eSpark-Backup/saleemd-customproduct/Hardware-Development/Deliverables/Renderings/2D_Top.jpg

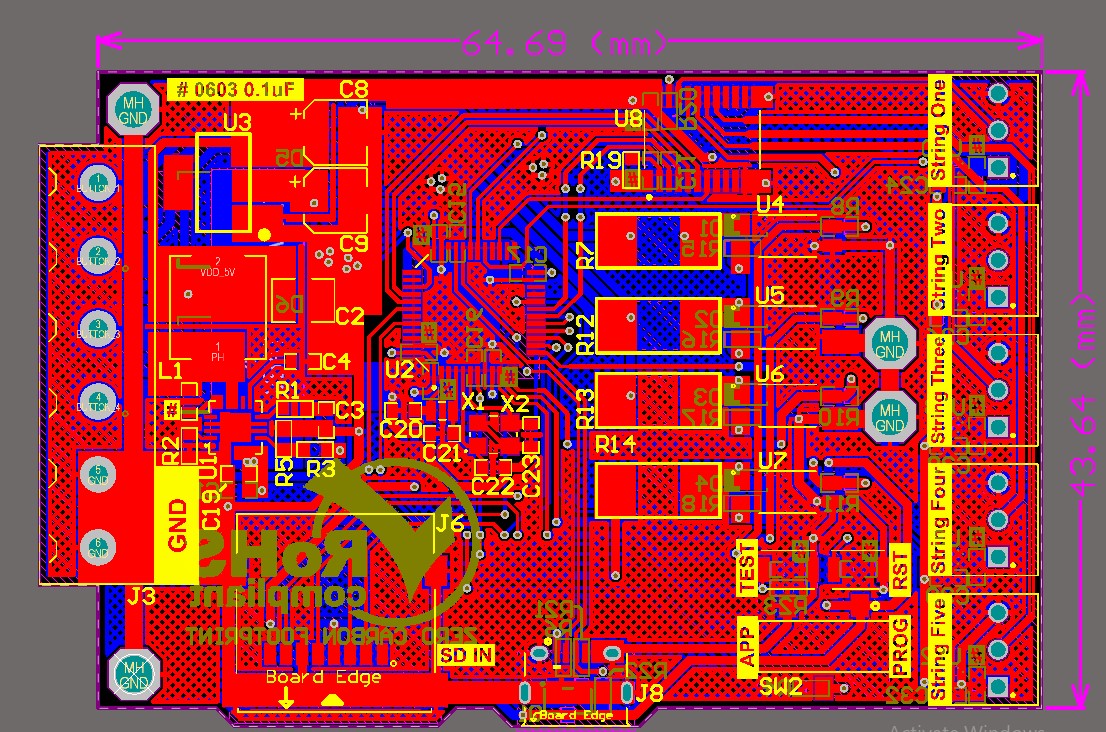
Hardware-Development/Deliverables/Renderings/2D_Top.jpg
