eSpark-Backup/saleemd-customproduct/Hardware-Development/Deliverables/Renderings/3D_Isometric.jpg

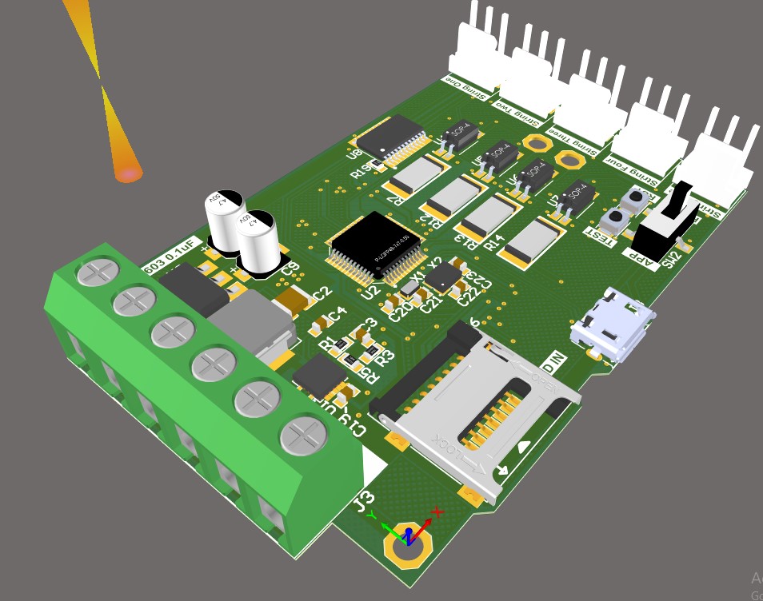
Hardware-Development/Deliverables/Renderings/3D_Isometric.jpg
