eSpark-Backup/saleemd-customproduct/README.md

To develop a custom product for client that is powered from a Car Battery and is able to switch different GPIOs on the output.
