eSpark-Backup/saleemd-customproduct/Hardware-Development/Design-Files/Saleem_PCB.PcbDoc.htm

Reporting Options

# File in Previous Format

Date | : | 2/14/2022
Time | : | 8:15:42 PM
Filename | : | C:\Users\HP\Documents\GitHub\SaleemD-CustomProduct\Hardware-Development\Design-Files\Saleem_PCB.PcbDoc

Version | Warning

This file was generated by an earlier version of the software
