eSpark-Backup/saleemd-customproduct/Hardware-Development/Deliverables/Renderings/3D_Bottom.jpg

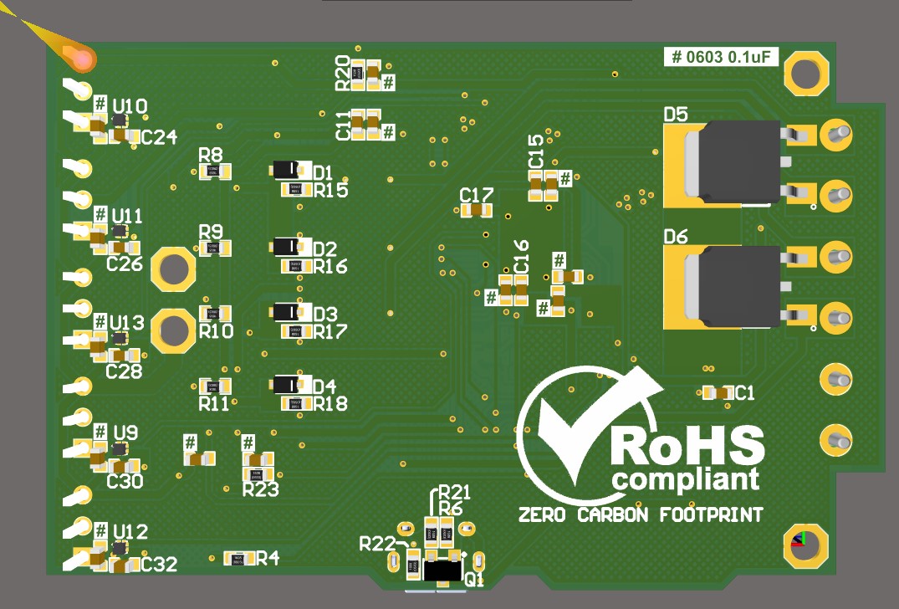
Hardware-Development/Deliverables/Renderings/3D_Bottom.jpg
