eSpark-Backup/saleemd-customproduct/Hardware-Development/Deliverables/Renderings/3D_Top.jpg

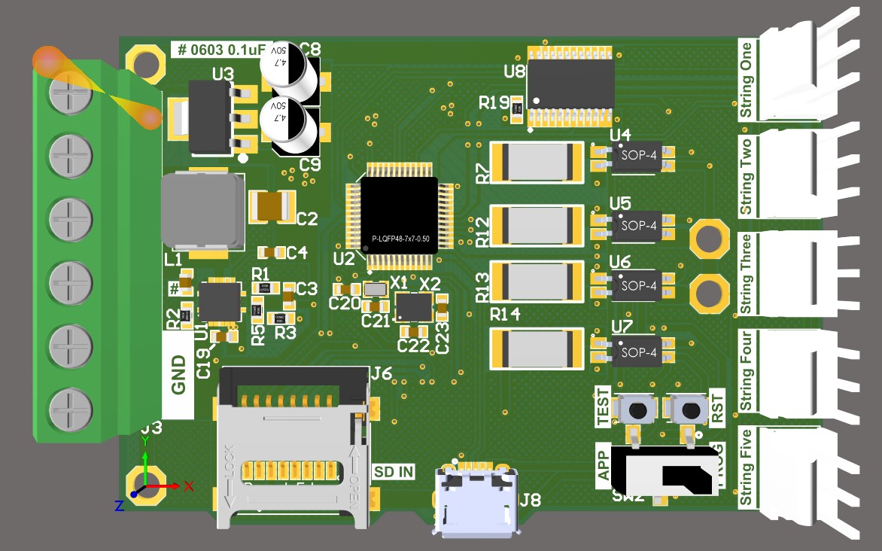
Hardware-Development/Deliverables/Renderings/3D_Top.jpg
