eSpark-Backup/saleemd-customproduct/Hardware-Development/Deliverables/BOM/BOM_LCSC.xlsx

Bill of Material (BOM) for Saleem Custom Product
S. No. | Components | Description | Designator | Footprint (Package) | Manufacturer Part Number | Manufacturer | LCSC Part No | Alternate | Value | LCSC/MOQ | Quantity (Per Board) | Quantity 5 | Link | Unit Cost(1) | Total Cost(1) | MOQ Total | Unit Cost (5 Boards) | Total Cost (5) | Remarks
1 | Capacitor | CAP CER 10UF 35V X5R 0603 | C1 | Cap0603 | GRM188R6YA106MA73D | Murata | C194427 | - | 10uF | 10 | 1 | 5 | LCSC (https://lcsc.com/product-detail/Multilayer-Ceramic-Capacitors-MLCC-SMD-SMT_Murata-Electronics-GRM188R6YA106MA73D_C194427.html) | $0.0609 | $0.0609 | $0.6090 | $0.0609 | $0.3045
2 |  | CAP CER 47uF 25V 1210 | C2 | Cap1210 | TMK325ABJ476MM-P | Taiyo | C90142 | - | 47uF | 7 | 1 | 5 | LCSC (https://lcsc.com/product-detail/Multilayer-Ceramic-Capacitors-MLCC-SMD-SMT_Taiyo-Yuden-TMK325ABJ476MM-P_C90142.html) | $0.5573 | $0.5573 | $3.9011 | $0.5573 | $2.7865
3 |  | CAP CER 8.2nF 50V X7R 10% 0603 | C3 | Cap0603 | CC0603KRX7R9BB822 | YAGEO | C113812 | - | 8200pF | 50 | 1 | 5 | LCSC (https://lcsc.com/product-detail/Multilayer-Ceramic-Capacitors-MLCC-SMD-SMT_YAGEO-CC0603KRX7R9BB822_C113812.html) | $0.0061 | $0.0061 | $0.3050 | $0.0061 | $0.0305
4 |  | CAP CER 10000PF 50V X7R 0603 | C4, C17 | Cap0603 | CC0603KRX7R9BB103 | YAGEO | C100042 | - | 10000pF | 100 | 2 | 10 | LCSC (https://lcsc.com/product-detail/Multilayer-Ceramic-Capacitors-MLCC-SMD-SMT_YAGEO-CC0603KRX7R9BB103_C100042.html) | $0.00280 | $0.0056 | $0.2800 | $0.00280 | $0.0280
5 |  | CAP CER 0.1UF 100V X7R 0603 | C5, C6, C7, C10, C12, C13, C14, C18, C25, C27, C29, C31, C33, C34 | Cap0603 | CC0603KRX7R0BB104 | YAGEO | C113803 | - | 0.1uF | 100 | 14 | 70 | LCSC (https://lcsc.com/product-detail/Multilayer-Ceramic-Capacitors-MLCC-SMD-SMT_YAGEO-CC0603KRX7R0BB104_C113803.html) | $0.0082 | $0.1148 | $0.8200 | $0.0082 | $0.5740
6 |  | CAP ALUM 10uF 25V SMD | C8, C9 | Custom | RVT1E100M0405 | ROQANG | C72484 | - | 10uF | 20 | 2 | 10 | LCSC (https://lcsc.com/product-detail/Aluminum-Electrolytic-Capacitors-SMD_ROQANG-RVT1E100M0405_C72484.html) | $0.0298 | $0.0596 | $0.5960 | $0.0298 | $0.2980
7 |  | CAP CER 1UF 25V X5R 0603 | C11, C15, C24, C26, C28, C30, C32 | Cap0603 | CC0603KRX5R8BB105 | YAGEO | C14664 | - | 1uF | 50 | 7 | 35 | LCSC (https://lcsc.com/product-detail/Multilayer-Ceramic-Capacitors-MLCC-SMD-SMT_YAGEO-CC0603KRX5R8BB105_C14664.html) | $0.0074 | $0.0518 | $0.3700 | $0.0074 | $0.2590
8 |  | CAP CER, 4.7 µF, 25 V, 0603 | C16, C19 | Cap0603 | C1608X5R1E475KT000E | TDK | C76615 | - | 4.7uF | 20 | 2 | 10 | LCSC (https://lcsc.com/product-detail/Multilayer-Ceramic-Capacitors-MLCC-SMD-SMT_TDK-C1608X5R1E475KT000E_C76615.html) | $0.0354 | $0.0708 | $0.7080 | $0.0354 | $0.3540
9 |  | CAP CER 10PF 50V C0G/NP0 0603 | C20, C21 | Cap0603 | ~~06035A100JAT2A~~ | AVX | C106245 | CC0603JRNPO9BN100 | 10pF | 100 | 2 | 10 | LCSC (https://lcsc.com/product-detail/Multilayer-Ceramic-Capacitors-MLCC-SMD-SMT_YAGEO-CC0603JRNPO9BN100_C106245.html) | $0.0025 | $0.0050 | $0.0032 | $0.0025 | $0.0250
10 |  | CAP CER 20PF 50V C0G/NP0 0603 | C22, C23 | Cap0603 | CL10C200JB8NNNC | Samsung | C1648 | - | 20pF | 50 | 2 | 10 | LCSC (https://lcsc.com/product-detail/Multilayer-Ceramic-Capacitors-MLCC-SMD-SMT_Samsung-Electro-Mechanics-CL10C200JB8NNNC_C1648.html) | $0.0051 | $0.0102 | $0.2550 | $0.0051 | $0.0510
11 | Diode | DIODE ZENER 3.3V 200MW SOD323F | D1, D2, D3, D4 | SOD323F | ~~MM3Z3V3B~~ | onsemi | C173439 | BZT52C3V3S | - | 40 | 4 | 20 | LCSC (https://lcsc.com/product-detail/Zener-Diodes_MDD-Microdiode-Electronics-BZT52C3V3S_C173439.html) | $0.0174 | $0.0696 | $0.6960 | $0.0174 | $0.3480
12 |  | DIODE ARRAY SCHOTTKY 60V 6A DPAK | D5, D6 | TO-252AA | VS-12CWQ06FNTR-M3 | Vishay | C467004 | - | - | 12 | 2 | 10 | LCSC (https://lcsc.com/product-detail/Schottky-Barrier-Diodes-SBD_Vishay-Intertech-VS-12CWQ06FNTR-M3_C467004.html) | $0.9359 | $1.8718 | $11.2308 | $0.6907 | $6.9070
13 | Inductor | FIXED IND 3.3UH 6A 36 MOHM SMD | L1 | Custom | IHLP2525CZER3R3M01 | Abracon | C506574 |  | 3.3 µH | 7 | 1 | 5 | LCSC (https://lcsc.com/product-detail/Power-Inductors_Vishay-Intertech-IHLP2525CZER3R3M01_C506574.html) | $0.8798 | $0.8798 | $6.1586 | $0.8798 | $4.3990
14 | Mosfet | TRANS NPN 40V 0.6A SMD SOT23-3 | Q1 | SOT-23 | MMBT2222A-7-F | Diodes | C94515 | - | - | 20 | 1 | 5 | LCSC (https://lcsc.com/product-detail/Bipolar-Transistors-BJT_Diodes-Incorporated-MMBT2222A-7-F_C94515.html) | $0.0407 | $0.0407 | $0.8140 | $0.0407 | $0.2035
15 | Resistor | RES SMD 1.69K 0.1W 0603 | R1 | Res0603 | CR0603-FX-1691ELF | Bourns | C203341 | - | 1K69 | 50 | 1 | 5 | LCSC (https://lcsc.com/product-detail/Chip-Resistor-Surface-Mount_BOURNS-CR0603-FX-1691ELF_C203341.html) | $0.0018 | $0.0018 | $0.0900 | $0.0018 | $0.0090
16 |  | RES SMD 100K OHM 5% 1/5W 0603 | R2 | Res0603 | CRGH0603J100K | TE | C161785 | - | 100K | 10 | 1 | 5 | LCSC (https://lcsc.com/product-detail/Chip-span-style-background-color-ff0-Resistor-span-Surface-Mount_PANASONIC-ERJPB3B1003V_C161785.html) | $0.0607 | $0.0607 | $0.6070 | $0.0607 | $0.3035
17 |  | RES SMD 0603 56K Ohm 5% 0.1W | R3 | Res0603 | RC0603JR-0756KL | YAGEO | C137618 | - | 56K | 100 | 1 | 5 | LCSC (https://lcsc.com/product-detail/Chip-Resistor-Surface-Mount_YAGEO-RC0603JR-0756KL_C137618.html) | $0.0024 | $0.0024 | $0.2400 | $0.0024 | $0.0120
18 |  | RES SMD 10K OHM 1% 1/10W 0603 | R4, R5, R6, R19, R20, R23 | Res0603 | RC0603FR-0710KL | YAGEO | C98220 | - | 10K | 100 | 6 | 30 | LCSC (https://lcsc.com/product-detail/Chip-Resistor-Surface-Mount_YAGEO-RC0603FR-0710KL_C98220.html) | $0.0014 | $0.0084 | $0.1400 | $0.0014 | $0.0420
19 |  | Resistors 200V 390Ω 2512 Chip Resistor SMD | R7, R12, R13, R14 | RES 2512 | 25121WF3900T4E | UNI-ROYAL | C60131 | - | 390R | 40 | 4 | 20 | LCSC (https://lcsc.com/product-detail/Chip-span-style-background-color-ff0-Resistor-span-Surface-Mount_UNI-ROYAL-Uniroyal-Elec-25121WF3900T4E_C60131.html) | $0.0376 | $0.1504 | $1.5040 | $0.0376 | $0.7520
20 |  | RES SMD 3.3K OHM 1% 1/10W 0603 | R8, R9, R10, R11 | Res0603 | RC0603FR-073K3L | YAGEO | C108078 | - | 3.3K | 100 | 4 | 20 | LCSC (https://lcsc.com/product-detail/Chip-Resistor-Surface-Mount_YAGEO-RC0603FR-073K3L_C108078.html) | $0.0017 | $0.0068 | $0.1700 | $0.0017 | $0.0340
21 |  | RES SMD 200 OHM 0.5% 1/10W 0603 | R15, R16, R17, R18 | Res0603 | RT0603DRD07200RL | YAGEO | C700498 | - | 200R | 50 | 4 | 20 | LCSC (https://lcsc.com/product-detail/Chip-Resistor-Surface-Mount_YAGEO-RT0603DRD07200RL_C700498.html) | $0.0150 | $0.0600 | $0.7500 | $0.0150 | $0.3000
22 |  | RES SMD 36K Ohm 1% 0.1W 0603 | R21 | Res0603 | RC0603FR-0736KL | YAGEO | C114619 | - | 36K | 100 | 1 | 5 | LCSC (https://lcsc.com/product-detail/Chip-Resistor-Surface-Mount_YAGEO-RC0603FR-0736KL_C114619.html) | $0.0014 | $0.0014 | $0.1400 | $0.0014 | $0.0070
23 |  | RES SMD 1.5K OHM 1% 1/10W 0603 | R22 | Res0603 | RC0603FR-071K5L | YAGEO | C114668 | - | 1.5K | 100 | 1 | 5 | LCSC (https://lcsc.com/product-detail/Chip-Resistor-Surface-Mount_YAGEO-RC0603FR-071K5L_C114668.html) | $0.0015 | $0.0015 | $0.1500 | $0.0015 | $0.0075
24 | Switch | SWITCH TACTILE SPST-NO 0.05A 12V | SW1, SW3 | Custom | B3U-1000P | Omron | C231329 | - | - | 12 | 2 | 10 | Custom Supplier (https://lcsc.com/product-detail/Tactile-Switches_Omron-Electronics-B3U-1000P_C231329.html) | $1.5000 | $3.0000 | $18.0000 | $1.5000 | $15.0000 | Out of stock on LCSC
25 |  | SPDT 50mA @ 12VDC 12V On-On SMD Toggle Switches RoHS | SW2 | Custom | SS-3235D-03-L2 | XKB | C381097 | - | - | 7 | 1 | 5 | LCSC (https://lcsc.com/product-detail/Slide-Switches_XKB-Connectivity-SS-3235D-03-L2_C381097.html) | $0.2845 | $0.2845 | $1.9915 | $0.2845 | $1.4225
26 | Crystal | SMD2012-2P Crystals ROHS | X1 | Custom | X1A000061002100 | Seiko | C55208 | X1A000061000200 | 32.768 KHz | 7 | 1 | 5 | LCSC (https://lcsc.com/product-detail/Crystals_Seiko-Epson-X1A000061000200_C55208.html) | $0.5663 | $0.5663 | $3.9641 | $0.5663 | $2.8315 | Alternate has same footprint and manufacturer
27 |  | 12V 50mA @ 12VDC SPDT On-On SMD Slide Switches ROHS | X2 | Custom | XXDCCLNANF-8.000000MHZ | TAITIEN | C521664 | - | 8000000Hz | 7 | 1 | 5 | LCSC (https://lcsc.com/product-detail/Crystals_TAITIEN-Elec-XXDCCLNANF-8-000000MHZ_C521664.html) | $0.4112 | $0.4112 | $2.8784 | $0.4112 | $2.0560
28 | Ics | IC REG BUCK ADJUSTABLE 6A 14VQFN | U1 | 14-VQFN (3.5x3.5) | TPS54620RHLR | Texas | C263274 | - | - | 6 | 1 | 5 | LCSC (https://lcsc.com/product-detail/DC-DC-Converters_Texas-Instruments-TPS54620RHLR_C263274.html) | $3.8356 | $3.8356 | $23.0136 | $3.8356 | $19.1780
29 |  | STM32F070CBT6TR | U2 | 48-LQFP (7x7) | STM32F070CBT6TR | STMicroelectronics | C2053863 | - | - | 6 | 1 | 5 | Custom Supplier (https://lcsc.com/product-detail/ST-Microelectronics_STMicroelectronics-STM32F070CBT6TR_C2053863.html) | $8.5700 | $8.5700 | $51.4200 | $8.5700 | $42.8500 | Out of stock on LCSC
30 |  | IC REG LINEAR 3.3V 1A SOT223 | U3 | SOT-223 | NCP1117LPST33T3G | onsemi | C146799 | - | - | 6 | 1 | 5 | LCSC (https://lcsc.com/product-detail/Linear-Voltage-Regulators-LDO_onsemi-NCP1117LPST33T3G_C146799.html) | $0.3005 | $0.3005 | $1.8030 | $0.3005 | $1.5025
31 |  | OPTOISOLATOR 2.5KV TRANS 4SOIC | U4, U5, U6, U7 | Custom | PS2801C-1-F3-A | Renesas | C67112 | - | - | 25 | 4 | 20 | LCSC (https://lcsc.com/product-detail/Optocouplers-Phototransistor-Output_RENESAS-PS2801C-1-F3-A_C67112.html) | $0.2658 | $1.0632 | $6.6450 | $0.2658 | $5.3160
32 |  | IC TRANSLATION TXRX 5.5V 24TSSOP | U8 | 24-TSSOP | SN74LVC8T245PWR | Texas | C27643 | - | - | 6 | 1 | 5 | LCSC (https://lcsc.com/product-detail/Translators-Level-Shifters_Texas-Instruments-SN74LVC8T245PWR_C27643.html) | $1.0964 | $1.0964 | $6.5784 | $1.0964 | $5.4820
33 |  | IC PWR SWITCH P-CHAN 1:1 4TMLF | U9, U10, U11, U12, U13 | 4-TMLF | MIC94082YFT-TR | Microchip | - | - | - | 30 | 5 | 25 | Aliexpress (https://www.alibaba.com/product-detail/Hot-selling-Transistor-TMLF-4-MIC94082YFT_1600234064562.html) | $0.4620 | $2.3100 | $13.8600 | $0.4620 | $11.5500
34 | Connector | CONN HEADER VERT 3POS 2.54MM | J1, J2, J4, J5, J7 | Custom | 640456-3 | TE | C86503 | - | - | 30 | 5 | 25 | LCSC (https://lcsc.com/product-detail/Wire-To-Board-Wire-To-Wire-Connector_TE-Connectivity-640456-3_C86503.html) | $0.09 | $0.4620 | $2.7720 | $0.09 | $2.3100
35 |  | P=5.0mm Screw terminal ROHS | J3 | Custom | WJ126V-5.0-6P | Ningbo | C8379 | - | - | 7 | 1 | 5 | LCSC (https://lcsc.com/product-detail/Screw-terminal_Ningbo-Kangnex-Elec-WJ126V-5-0-6P_C8379.html) | $0.2500 | $0.2500 | $1.7500 | $0.2500 | $1.2500
36 |  | CONN MICRO SD CARD PUSH-PULL R/A | J6 | Custom | TF-002T-15 | SOFNG | C125616 |  | -- | 7 | 1 | 5 | LCSC (https://lcsc.com/product-detail/SD-Card-Connectors_SOFNG-TF-002T-15_C125616.html) | $0.1804 | $0.1804 | $1.2628 | $0.1443 | $0.7215
37 |  | CONN RCPT USB2.0 MICRO B SMD R/A | J8 | Custom | 10118194-0001LF | Amphenol | C132563 | - | - | 7 | 1 | 5 | LCSC (https://www.lcsc.com/product-detail/USB-Connectors_Amphenol-ICC-10118194-0001LF_C132563.html) | $0.2242 | $0.2242 | $1.5694 | $0.2242 | $1.1210
 |  |  |  |  |  |  |  |  |  |  | Total Component Cost |  |  |  |  | $168.05 |  | $130.63
 |  |  |  |  |  |  |  |  |  |  | Single Board Cost |  |  |  | $26.65 | $33.61 |  | $26.13
