eSpark-Backup/saleemd-customproduct/Hardware-Development/Deliverables/BOM/Digikey_BOM.xlsx

Bill of Material (BOM) for Saleem Custom Product
S. No. | Components | Description | Designator | Footprint (Package) | Manufacturer Part Number | Manufacturer | Alternate | Value | Quantity (Per Board) | Quantity 5 | Link | Unit Cost(1) | Total Cost(1) | Unit Cost (5 Boards) | Total Cost (5) | Remarks
1 | Capacitor | CAP CER 10UF 35V X5R 0603 | C1 | Cap0603 | GRM188R6YA106MA73D | Murata | - | 10uF | 1 | 5 | Digikey (https://www.digikey.com/en/products/detail/murata-electronics/GRM188R6YA106MA73D/5877411) | $0.4500 | $0.4500 | $0.4500 | $2.2500
2 |  | CAP CER 47uF 25V 1210 | C2 | Cap1210 | TMK325ABJ476MM-P | Taiyo | - | 47uF | 1 | 5 | Digikey (https://www.digikey.com/en/products/detail/taiyo-yuden/TMK325ABJ476MM-P/7067064) | $1.1300 | $1.1300 | $1.1300 | $5.6500
3 |  | CAP CER 8.2nF 50V X7R 10% 0603 | C3 | Cap0603 | CC0603KRX7R9BB822 | YAGEO | - | 8200pF | 1 | 5 | Digikey (https://www.digikey.com/en/products/detail/yageo/CC0603KRX7R9BB822/5195218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) | $0.1000 | $0.1000 | $0.1000 | $0.5000
4 |  | CAP CER 10000PF 50V X7R 0603 | C4, C17 | Cap0603 | CC0603KRX7R9BB103 | YAGEO | - | 10000pF | 2 | 10 | Digikey (https://www.digikey.com/en/products/detail/yageo/CC0603KRX7R9BB103/302819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) | $0.1000 | $0.2000 | $0.0370 | $0.3700
5 |  | CAP CER 0.1UF 100V X7R 0603 | C5, C6, C7, C10, C12, C13, C14, C18, C25, C27, C29, C31, C33, C34 | Cap0603 | CC0603KRX7R0BB104 | YAGEO | - | 0.1uF | 14 | 70 | Digikey (https://www.digikey.com/en/products/detail/yageo/CC0603KRX7R0BB104/3476111) | $0.1900 | $2.6600 | $0.0768 | $5.3760
6 |  | CAP ALUM 10uF 25V SMD | C8, C9 | Custom | ~~RVT1E100M0405~~ | ROQANG | EEV106M025A9BAA | 10uF | 2 | 10 | Digikey (https://www.digikey.com/en/products/detail/kemet/EEV106M025A9BAA/3083109) | $0.4300 | $0.8600 | $0.4300 | $4.3000 | Alternate Part use Footprint need to be change in design
7 |  | CAP CER 1UF 25V X5R 0603 | C11, C15, C24, C26, C28, C30, C32 | Cap0603 | CC0603KRX5R8BB105 | YAGEO | - | 1uF | 7 | 35 | Digikey (https://www.digikey.com/en/products/detail/yageo/CC0603KRX5R8BB105/2833610) | $0.1200 | $0.8400 | $0.0840 | $2.9400
8 |  | CAP CER, 4.7 µF, 25 V, 0603 | C16, C19 | Cap0603 | C1608X5R1E475KT000E | TDK | - | 4.7uF | 2 | 10 | Digikey (https://www.digikey.com/en/products/detail/tdk-corporation/C1608X5R1E475K080AC/3648581) | $0.3600 | $0.7200 | $0.2500 | $2.5000
9 |  | CAP CER 10PF 50V C0G/NP0 0603 | C20, C21 | Cap0603 | 06035A100JAT2A | KYOCERA | - | 10pF | 2 | 10 | Digikey (https://www.digikey.com/en/products/detail/kyocera-avx/06035A100JAT2A/563273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) | $0.1000 | $0.2000 | $0.0480 | $0.4800
10 |  | CAP CER 20PF 50V C0G/NP0 0603 | C22, C23 | Cap0603 | CL10C200JB8NNNC | Samsung | - | 20pF | 2 | 10 | Digikey (https://www.digikey.com/en/products/detail/samsung-electro-mechanics/CL10C200JB8NNNC/3886845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) | $0.1000 | $0.2000 | $0.0490 | $0.4900
11 | Diode | DIODE ZENER 3.3V 200MW SOD323F | D1, D2, D3, D4 | SOD323F | MM3Z3V3B | onsemi | - | - | 4 | 20 | Digikey (https://www.digikey.com/en/products/detail/onsemi/MM3Z3V3B/1626765) | $0.2500 | $1.0000 | $0.2050 | $4.1000
12 |  | DIODE ARRAY SCHOTTKY 60V 6A DPAK | D5, D6 | TO-252AA | VS-12CWQ06FNTR-M3 | Vishay | - | - | 2 | 10 | Digikey (https://www.digikey.com/en/products/detail/vishay-general-semiconductor-diodes-division/VS-12CWQ06FNTR-M3/4933557) | $0.9700 | $1.9400 | $0.8640 | $8.6400
13 | Inductor | FIXED IND 3.3UH 6.5A 36 MOHM SMD | L1 | Custom | ASPI-0530LR-3R3M-T2 | Abracon | - | 3.3 µH | 1 | 5 | Digikey (https://www.digikey.com/en/products/detail/abracon-llc/ASPI-0530LR-3R3M-T2/3059585) | $0.9200 | $0.9200 | $0.9200 | $4.6000
14 | Mosfet | TRANS NPN 40V 0.6A SMD SOT23-3 | Q1 | SOT-23 | MMBT2222A-7-F | Diodes | - | - | 1 | 5 | Digikey (https://www.digikey.com/en/products/detail/diodes-incorporated/MMBT2222A-7-F/814503) | $0.1400 | $0.1400 | $0.1400 | $0.7000
15 | Resistor | RES SMD 1.69K 0.1W 0603 | R1 | Res0603 | CR0603-FX-1691ELF | Bourns | - | 1K69 | 1 | 5 | Digikey (https://www.digikey.com/en/products/detail/bourns-inc/CR0603-FX-1691ELF/3783774) | $0.1000 | $0.1000 | $0.1000 | $0.5000
16 |  | RES SMD 100K OHM 5% 1/5W 0603 | R2 | Res0603 | CRGH0603J100K | TE | - | 100K | 1 | 5 | Digikey (https://www.digikey.com/en/products/detail/te-connectivity-passive-product/CRGH0603J100K/2385403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) | $0.1000 | $0.1000 | $0.1000 | $0.5000
17 |  | RES SMD 0603 56K Ohm 5% 0.1W | R3 | Res0603 | RC0603JR-0756KL | YAGEO | - | 56K | 1 | 5 | Digikey (https://www.digikey.com/en/products/detail/yageo/RC0603JR-0756KL/726808) | $0.1000 | $0.1000 | $0.1000 | $0.5000
18 |  | RES SMD 10K OHM 1% 1/10W 0603 | R4, R5, R6, R19, R20, R23 | Res0603 | RC0603FR-0710KL | YAGEO | - | 10K | 6 | 30 | Digikey (https://www.digikey.com/en/products/detail/yageo/RC0603FR-0710KL/726880) | $0.1000 | $0.6000 | $0.0240 | $0.7200
19 |  | RES 390 OHM 5% 1W 2512 | R7, R12, R13, R14 | Res 2512 | RMCF2512JT390R | Stack Pole | - | 390R | 4 | 20 | Digikey (https://www.digikey.com/en/products/detail/stackpole-electronics-inc/RMCF2512JT390R/1756999) | $0.3000 | $1.2000 | $0.2530 | $5.0600
20 |  | RES SMD 3.3K OHM 1% 1/10W 0603 | R8, R9, R10, R11 | Res0603 | RC0603FR-073K3L | YAGEO | - | 3.3K | 4 | 20 | Digikey (https://www.digikey.com/en/products/detail/yageo/RC0603FR-073K3L/727126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) | $0.1000 | $0.4000 | $0.0240 | $0.4800
21 |  | RES SMD 200 OHM 0.5% 1/10W 0603 | R15, R16, R17, R18 | Res0603 | RT0603DRD07200RL | YAGEO | - | 200R | 4 | 20 | Digikey (https://www.digikey.com/en/products/detail/yageo/RT0603DRD07200RL/1035476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) | $0.1800 | $0.7200 | $0.1510 | $3.0200
22 |  | RES SMD 36K Ohm 1% 0.1W 0603 | R21 | Res0603 | RC0603FR-0736KL | YAGEO | - | 36K | 1 | 5 | Digikey (https://www.digikey.com/en/products/detail/yageo/RC0603FR-0736KL/727179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) | $0.1000 | $0.1000 | $0.1000 | $0.5000
23 |  | RES SMD 1.5K OHM 1% 1/10W 0603 | R22 | Res0603 | RC0603FR-071K5L | YAGEO | - | 1.5K | 1 | 5 | Digikey (https://www.digikey.com/en/products/detail/yageo/RC0603FR-071K5L/726864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) | $0.1000 | $0.1000 | $0.1000 | $0.5000
24 | Switch | SWITCH TACTILE SPST-NO 0.05A 12V | SW1, SW3 | Custom | B3U-1000P | Omron | - | - | 2 | 10 | Digikey (https://www.digikey.com/en/products/detail/omron-electronics-inc-emc-div/B3U-1000P/1534338) | $0.9600 | $1.9200 | $0.9600 | $9.6000
25 |  | SPDT 50mA @ 12VDC 12V On-On SMD Toggle Switches RoHS | SW2 | Custom | SS-3235D-03-L2 | Seiko | - | - | 1 | 5 | Custom supplier | $1.2000 | $1.2000 | $1.2000 | $6.0000
26 | Crystal | SMD2012-2P Crystals ROHS | X1 | Custom | ~~X1A000061002100~~ | Seiko | RT2012-32.768-6-TR | 32.768 KHz | 1 | 5 | Digikey (https://www.digikey.com/en/products/detail/raltron-electronics/RT2012-32-768-6-TR/10273013) | $0.8400 | $0.8400 | $0.8400 | $4.2000 | Alternate Part use Footprint need to be change in design
27 |  | 12V 50mA @ 12VDC SPDT On-On SMD Slide Switches ROHS | X2 | Custom | XXDCCLNANF-8.000000MHZ | TAITIEN | - | 8000000Hz | 1 | 5 | Custom supplier (https://lcsc.com/product-detail/Crystals_TAITIEN-Elec-XXDCCLNANF-8-000000MHZ_C521664.html) | $1.6000 | $1.6000 | $1.6000 | $8.0000
28 | Ics | IC REG BUCK ADJUSTABLE 6A 14VQFN | U1 | 14-VQFN (3.5x3.5) | TPS54620RHLR | Texas | - | - | 1 | 5 | Digikey (https://www.digikey.com/en/products/detail/texas-instruments/TPS54620RHLR/2674340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) | $5.8000 | $5.8000 | $5.8000 | $29.0000
29 |  | STM32F070CBT6TR | U2 | 48-LQFP (7x7) | STM32F070CBT6TR | STMicroelectronics | - | - | 1 | 5 | Digikey (https://www.digikey.com/en/products/detail/stmicroelectronics/STM32F070CBT6TR/5268203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) | $3.4000 | $3.4000 | $3.4000 | $17.0000
30 |  | IC REG LINEAR 3.3V 1A SOT223 | U3 | SOT-223 | NCP1117LPST33T3G | onsemi | - | - | 1 | 5 | Arrow (https://www.arrow.com/en/products/ncp1117lpst33t3g/on-semiconductor?region=nac) | $0.4500 | $0.4500 | $0.4500 | $2.2500
31 |  | OPTOISOLATOR 2.5KV TRANS 4SOIC | U4, U5, U6, U7 | Custom | PS2801C-1-F3-A | Renesas | - | - | 4 | 20 | Mouser (https://eu.mouser.com/ProductDetail/Renesas-Electronics/PS2801C-1-F3-A) | $0.8100 | $3.2400 | $0.8100 | $16.2000
32 |  | IC TRANSLATION TXRX 5.5V 24TSSOP | U8 | 24-TSSOP | SN74LVC8T245PWR | Texas | - | - | 1 | 5 | Digikey (https://www.digikey.com/en/products/detail/texas-instruments/SN74LVC8T245PWR/857773) | $1.2600 | $1.2600 | $1.2600 | $6.3000
33 |  | IC PWR SWITCH P-CHAN 1:1 4TMLF | U9, U10, U11, U12, U13 | 4-TMLF | MIC94082YFT-TR | Microchip | - | - | 5 | 25 | Digikey (https://www.digikey.com/en/products/detail/microchip-technology/MIC94082YFT-TR/1980901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) | $0.4800 | $2.4000 | $0.4800 | $12.0000
34 | Connector | CONN HEADER VERT 3POS 2.54MM | J1, J2, J4, J5, J7 | Custom | 640456-3 | TE | - | - | 5 | 25 | Avnet (https://www.avnet.com/shop/us/products/te-connectivity/640456-3-3074457345626649953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) | $0.1735 | $0.8674 | $0.1735 | $4.3368
35 |  | TERM BLK 3P SIDE ENT 5.08MM PCB | J3 | Custom | ~~WJ126V-5.0-6P~~ | Phoenix | 1715857 | - | 2 | 10 | Digikey (https://www.digikey.com/en/products/detail/phoenix-contact/1715857/1926192) | $2.1900 | $4.3800 | $2.1900 | $21.9000
36 |  | CONN MICRO SD CARD PUSH-PULL R/A | J6 | Custom | 114-00841-68 | Amphenol | - | -- | 1 | 5 | Digikey (https://www.digikey.com/en/products/detail/amphenol-icc-commercial-products/114-00841-68/2187086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) | $1.4000 | $1.4000 | $1.4000 | $7.0000
37 |  | CONN RCPT USB2.0 MICRO B SMD R/A | J8 | Custom | 10118194-0001LF | Amphenol | - | - | 1 | 5 | Digikey (https://www.digikey.com/en/products/detail/amphenol-icc-fci/10118194-0001LF/2785389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) | $0.4500 | $0.4500 | $0.4500 | $2.2500
 |  |  |  |  |  |  | Total Component Cost |  |  |  |  |  | $43.9873 |  | $200.71
 |  |  |  |  |  |  | Single Board Cost |  |  |  |  |  |  |  | $40.14
