eSpark-Backup/saleemd-customproduct/Hardware-Development/Documents/Dev-Files/Part Selection.xlsx

 |  | SaleemD-Part Selection
Component | Part number |  | Link | Alternate | Remarks
Buck regulator |  |  | LCSC (https://www.lcsc.com/product-detail/DC-DC-Converters_Texas-Instruments-TPS56C215RNNR_C473372.html) | LCSC (https://www.lcsc.com/product-detail/DC-DC-Converters_Texas-Instruments-TPS54620RHLR_C263274.html) | For 12A and 6A
MCU | STM32F030F4P6 |  | LCSC (https://lcsc.com/product-detail/ST-Microelectronics_STMicroelectronics-STM32F030F4P6_C32908.html)
Buffer IC | SN74LV07APWR |  | LCSC (https://www.lcsc.com/product-detail/Buffers-Drivers_Texas-Instruments-SN74LV07APWR_C133848.html)
Power Switch | SLG59M1470V |  | DigiKey (https://www.digikey.com/en/products/detail/dialog-semiconductor-gmbh/SLG59M1470V/7562849) |  | LCSC didn’t have ICs with current rating more than 1.3A
LED connector | 640456-3 |  | LCSC (https://www.lcsc.com/product-detail/Wire-To-Board-Wire-To-Wire-Connector_TE-Connectivity-640456-3_C86503.html) | Aliexpress (https://www.aliexpress.com/item/4001255635347.html)
3.3V regulator | NCP1117LPST33T3G |  | LCSC (https://www.lcsc.com/product-detail/Linear-Voltage-Regulators-span-style-background-color-ff0-LDO-span_ON-Semiconductor-NCP1117LPST33T3G_C146799.html) | LCSC (https://www.lcsc.com/product-detail/Linear-Voltage-Regulators-span-style-background-color-ff0-LDO-span_ABLIC-S-1172B33-E6T1U_C140913.html)
Terminal blocks | WJ126V-5.0-6P |  | LCSC (https://www.lcsc.com/product-detail/Screw-span-style-background-color-ff0-terminal-span_Ningbo-Kangnex-Elec-WJ126V-5-0-6P_C8379.html)
Capacitors |  | 100nF/25V |  |  | any capacitors with 0603 package
 |  | 1uF/25V
 |  | 4.7uF/25V
 |  | 10nF/25V
Transistor | IRF530SPBF |  | LCSC (https://www.lcsc.com/product-detail/MOSFETs_Vishay-Intertech-IRF530SPBF_C506474.html) | LCSC (https://www.lcsc.com/product-detail/MOSFETs_Winsok-Semicon-WSF12N10_C148434.html)
Tactile switch | B3U-1000P |  | LCSC (https://lcsc.com/product-detail/Tactile-Switches_Omron-Electronics-B3U-1000P_C231329.html)
Ferrite bead | SBM1608G601GSP |  | LCSC (https://www.lcsc.com/product-detail/span-style-background-color-ff0-Ferrite-span-Beads_Sunltech-Tech-SBM1608G601GSP_C216132.html)
Crystal | X1A000061002100 | 32.768KHz | LCSC (https://www.lcsc.com/product-detail/Crystals_Seiko-Epson-X1A000061002100_C255767.html)
 | XXDCCLNANF-8.000000MHZ | 8MHz | LCSC (https://www.lcsc.com/product-detail/Crystals_TAITIEN-Elec-XXDCCLNANF-8-000000MHZ_C521664.html)
Resistor | RC2512JK-07100RL | 100R | LCSC (https://www.lcsc.com/product-detail/Chip-span-style-background-color-ff0-Resistor-span-Surface-Mount_YAGEO-RC2512JK-07100RL_C163337.html)
 |  | 1K/0603
 |  | 52.5K
 |  | 10K
6 pin header for programming
Inductor | ASPI-0530LR-3R3M-T2 | DigiKey (https://www.digikey.com/en/products/detail/abracon-llc/ASPI-0530LR-3R3M-T2/3059585) | Aliexpress (https://www.aliexpress.com/item/4000833524419.html) |  | Not available on LCSC
