eSpark-Backup/saleemd-customproduct/Hardware-Development/Deliverables/Supporting Files/Saleem_PCB.step

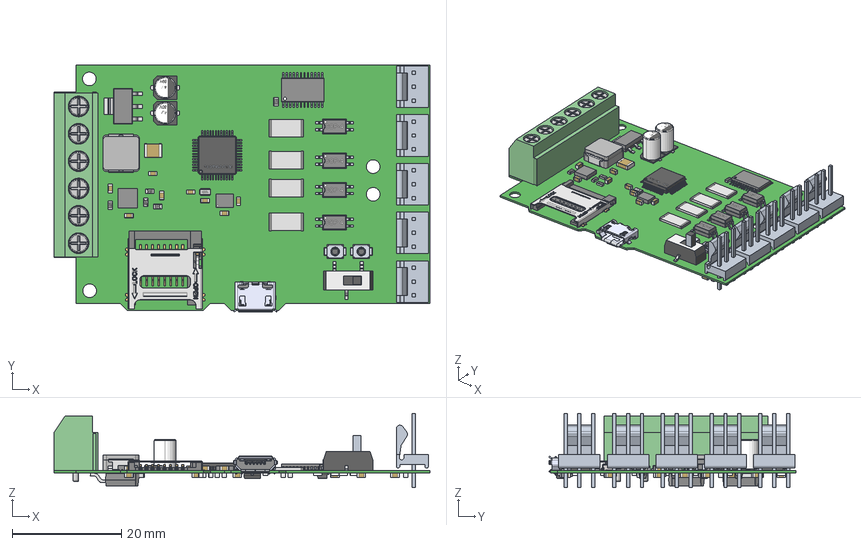
[picture p5: CAD file, 2021-10-22]
Hardware-Development/Deliverables/Supporting Files/Saleem_PCB.step
68.7 x 45.2 x 13.6 mm
Board
User_Library-SOD323F-1 x 4
CircuitWorks-RESISTOR_2512 x 4
1X07
SFE-NEW-WEBLOGO
DOD
IHLP2525CZ
10118194-0001LF--3DModel-STEP-56544
User_Library-4x5_4 x 2
User_Library-SOP-4-1 x 4
User_Library-OMRON_B3U1000P x 2
User_Library-RESC1608X05N x 19
User_Library-CAPC1608X09 x 31
User_Library-XTAL-3_2x2_5
User_Library-ABS06-1
MIC94082YFT-TR x 5
SN74LVC8T245MPWREP
User_Library-SOT-223-1
User_Library-P-LQFP48-7x7-0_50
ss-3235d-03-l2
CircuitWorks-SOT-23
Screw_Terminal_Block_5mm_6-way
User_Library-DPAK-1 x 2
User_Library-CAPC3225X10
