eSpark-Backup/saleemd-customproduct/(list of files, cad)

Other CAD files:
Hardware-Development/Deliverables/Supporting Files/Saleem_PCB.DWG
Hardware-Development/Deliverables/Supporting Files/Saleem_PCB.DXF
