eSpark-Backup/saleemd-customproduct/Hardware-Development/Design-Files/SaleemD_Project.pdf

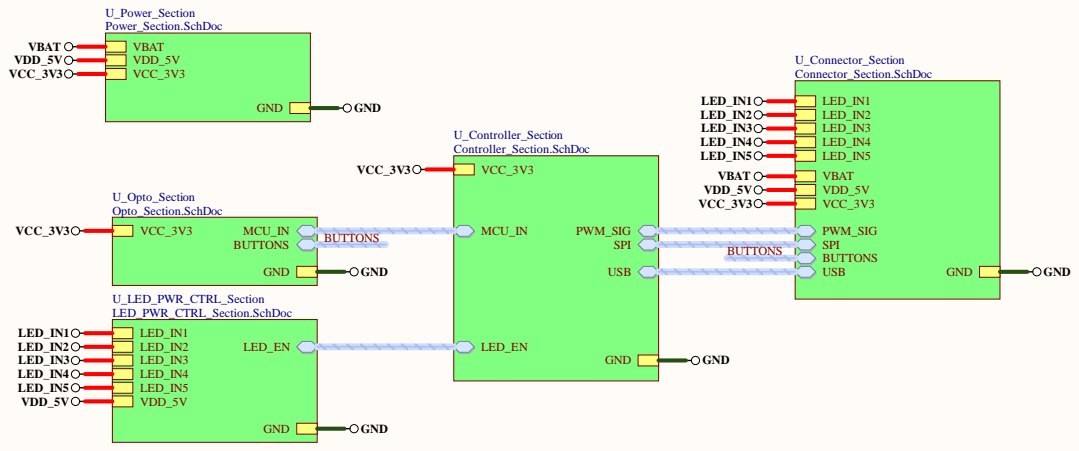
[picture p6: page 1]

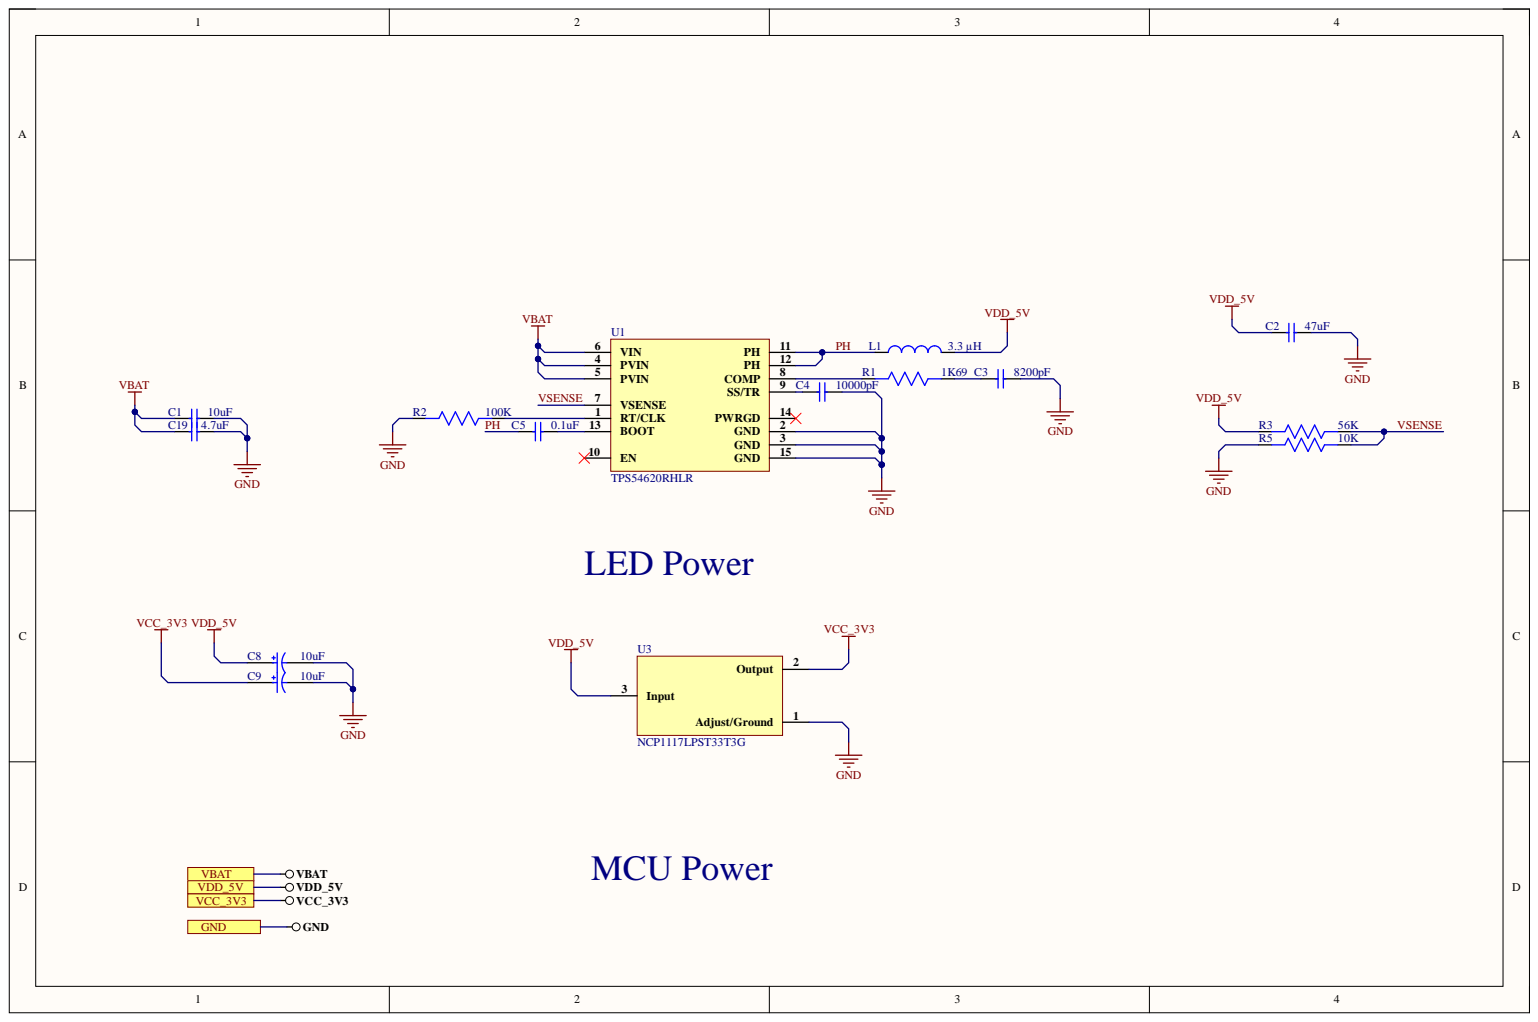
[picture p7: page 2]

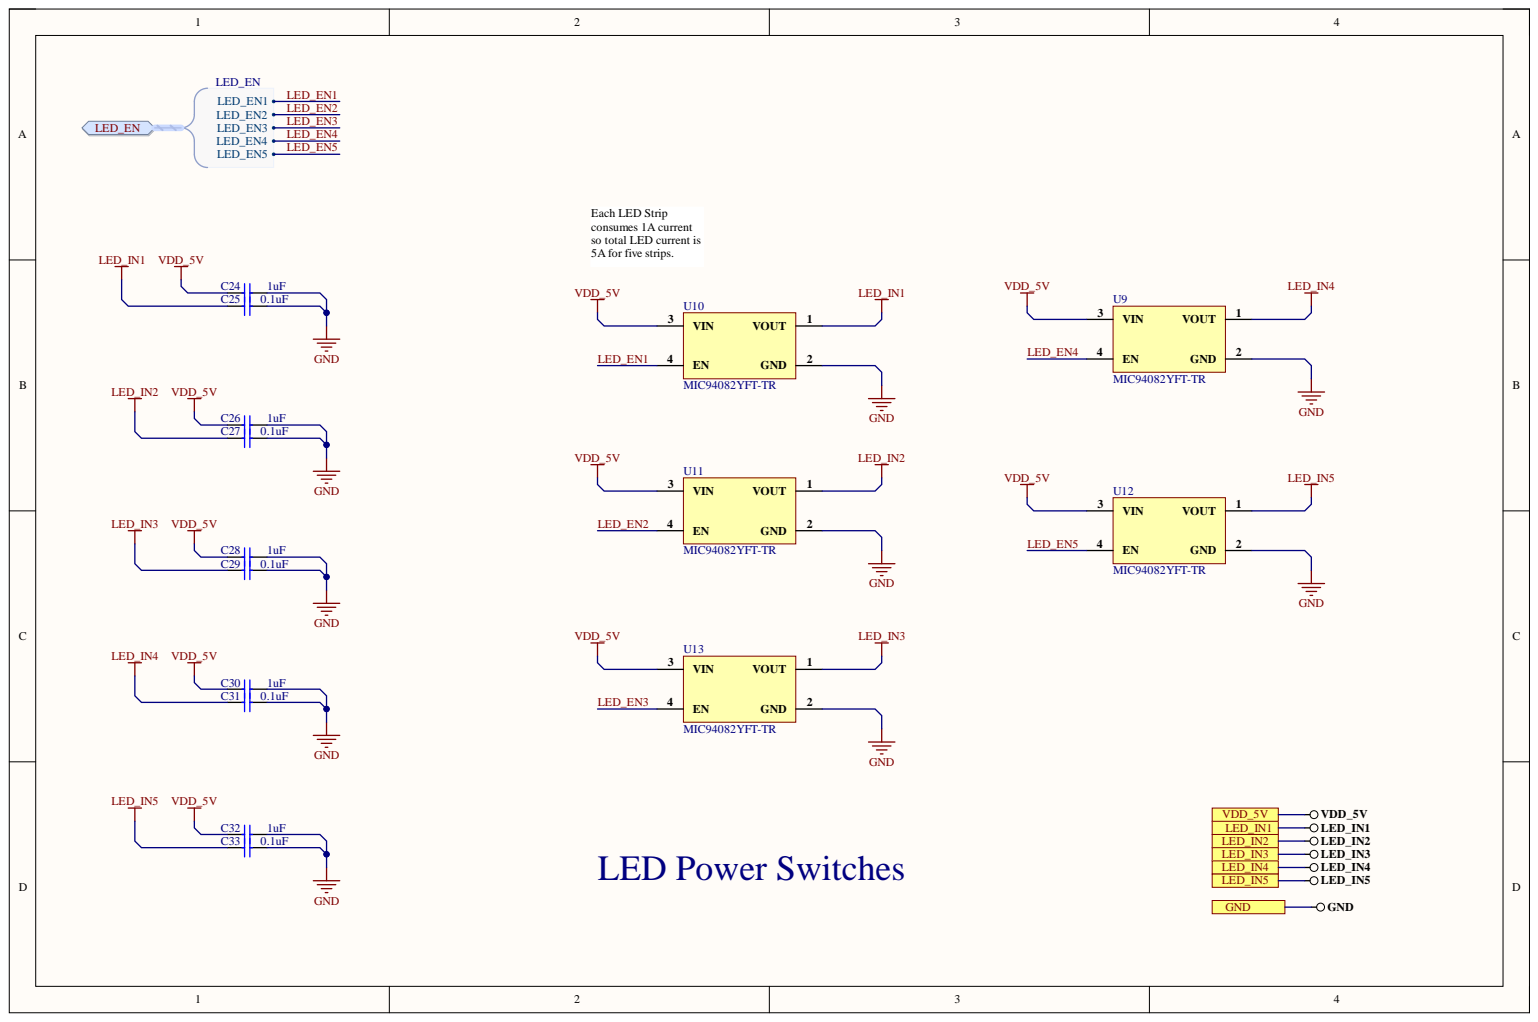
[picture p8: page 3]

LED Power Switches Each LED Strip

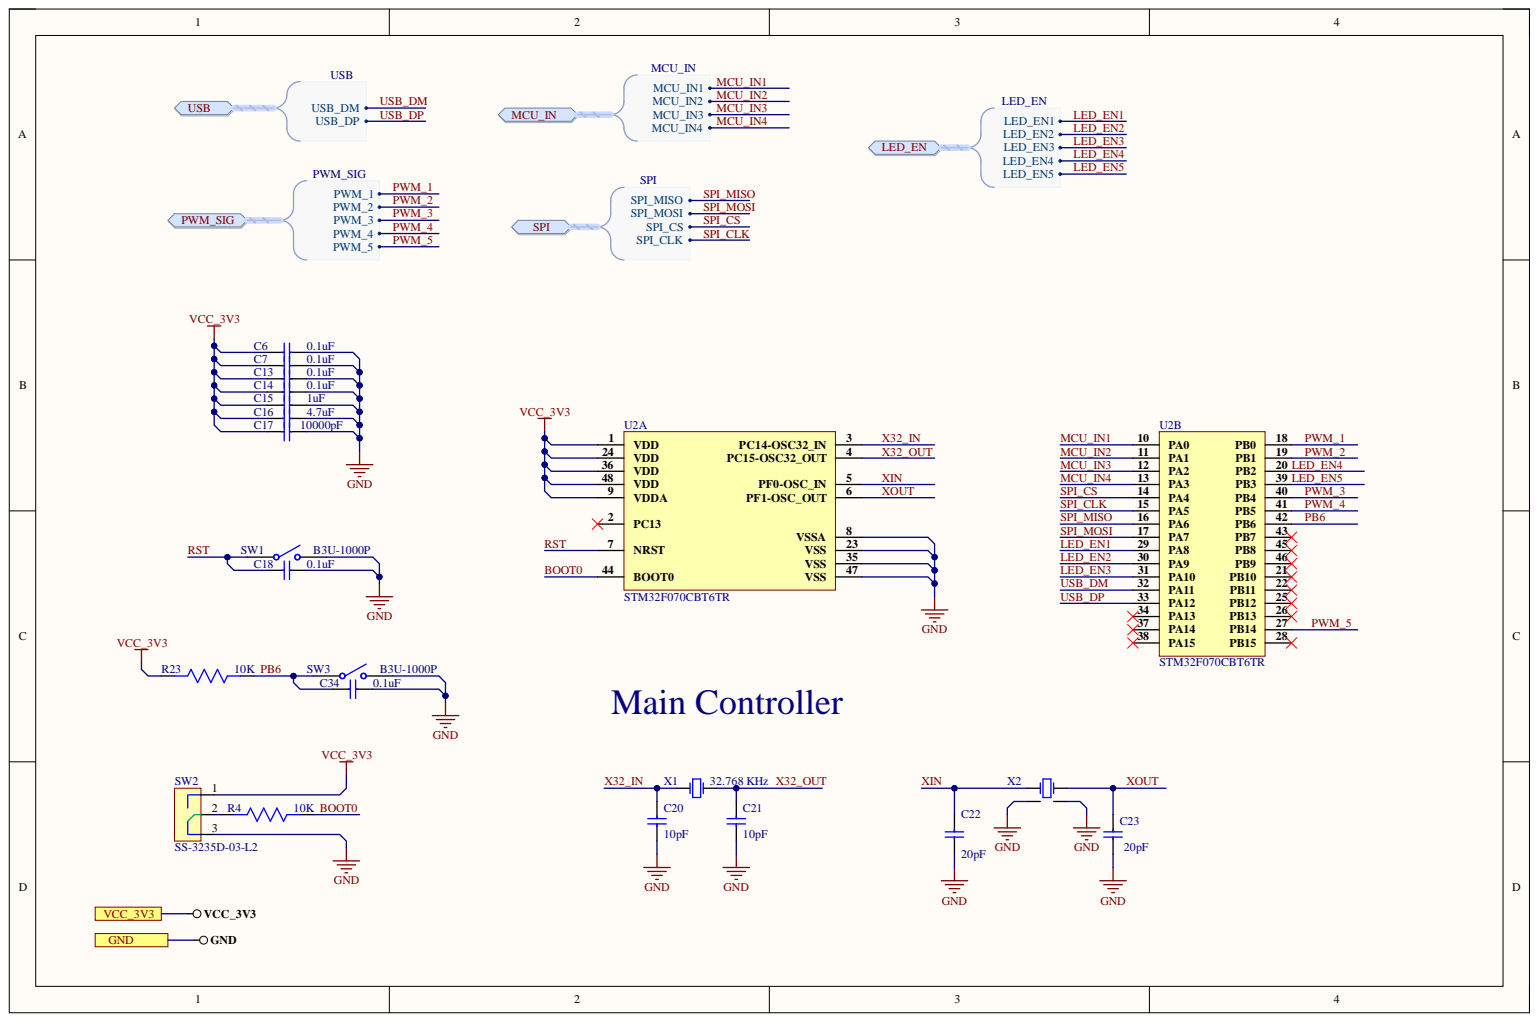
[picture p9: page 4]

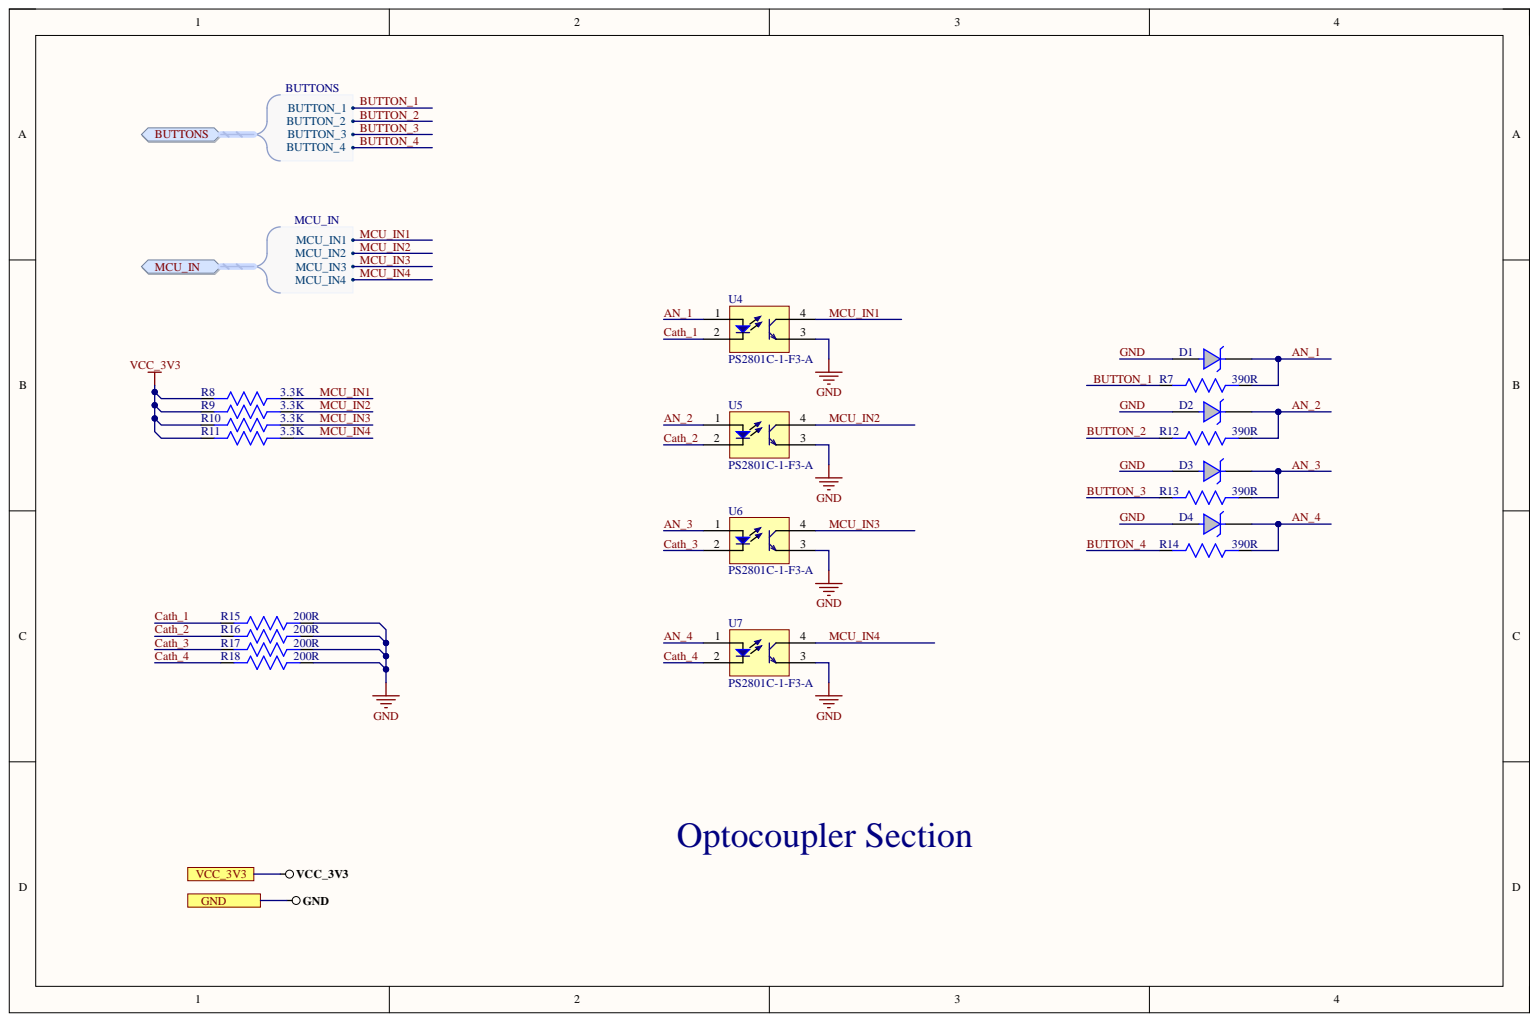
[picture p10: page 5]

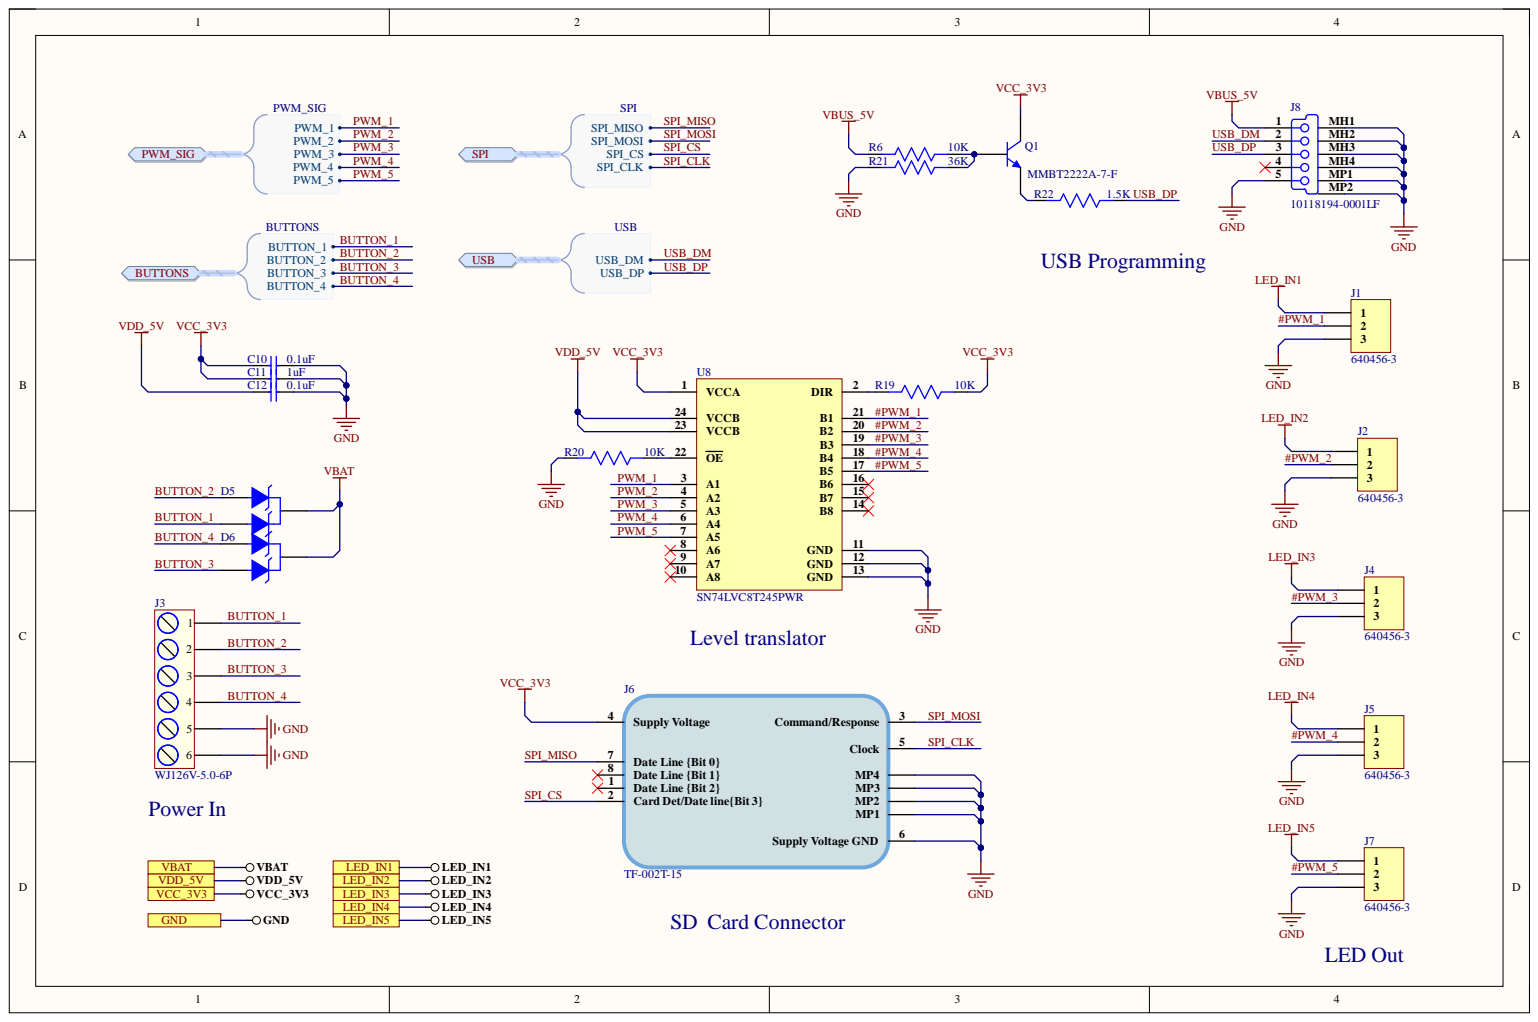
[picture p11: page 6]

Date Line {Bit 0} 7
Date Line {Bit 1} 8
Date Line {Bit 2} 1
Card Det/Date line{Bit 3} 2
