eSpark-Backup/saleemd-customproduct/Hardware-Development/Deliverables/Schematics/Saleem_Schematic_View.pdf

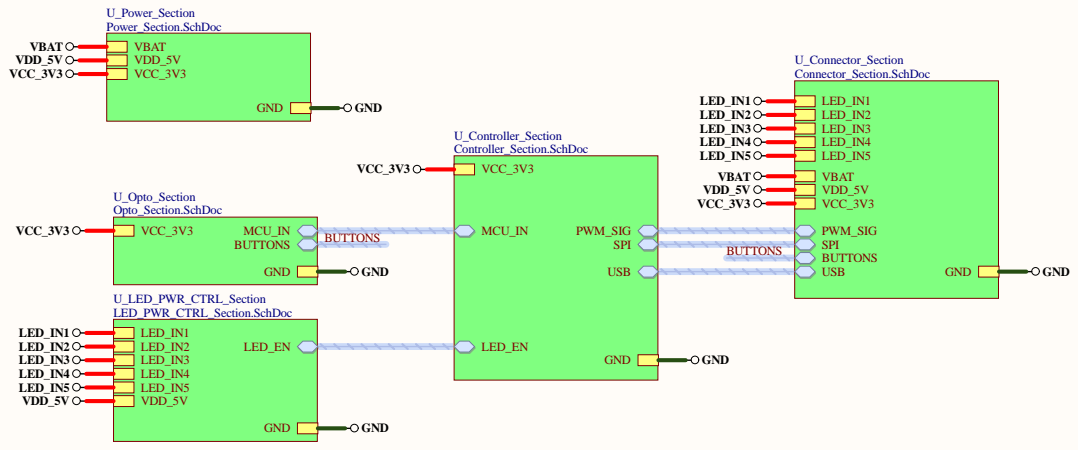
[picture p12: page 1]

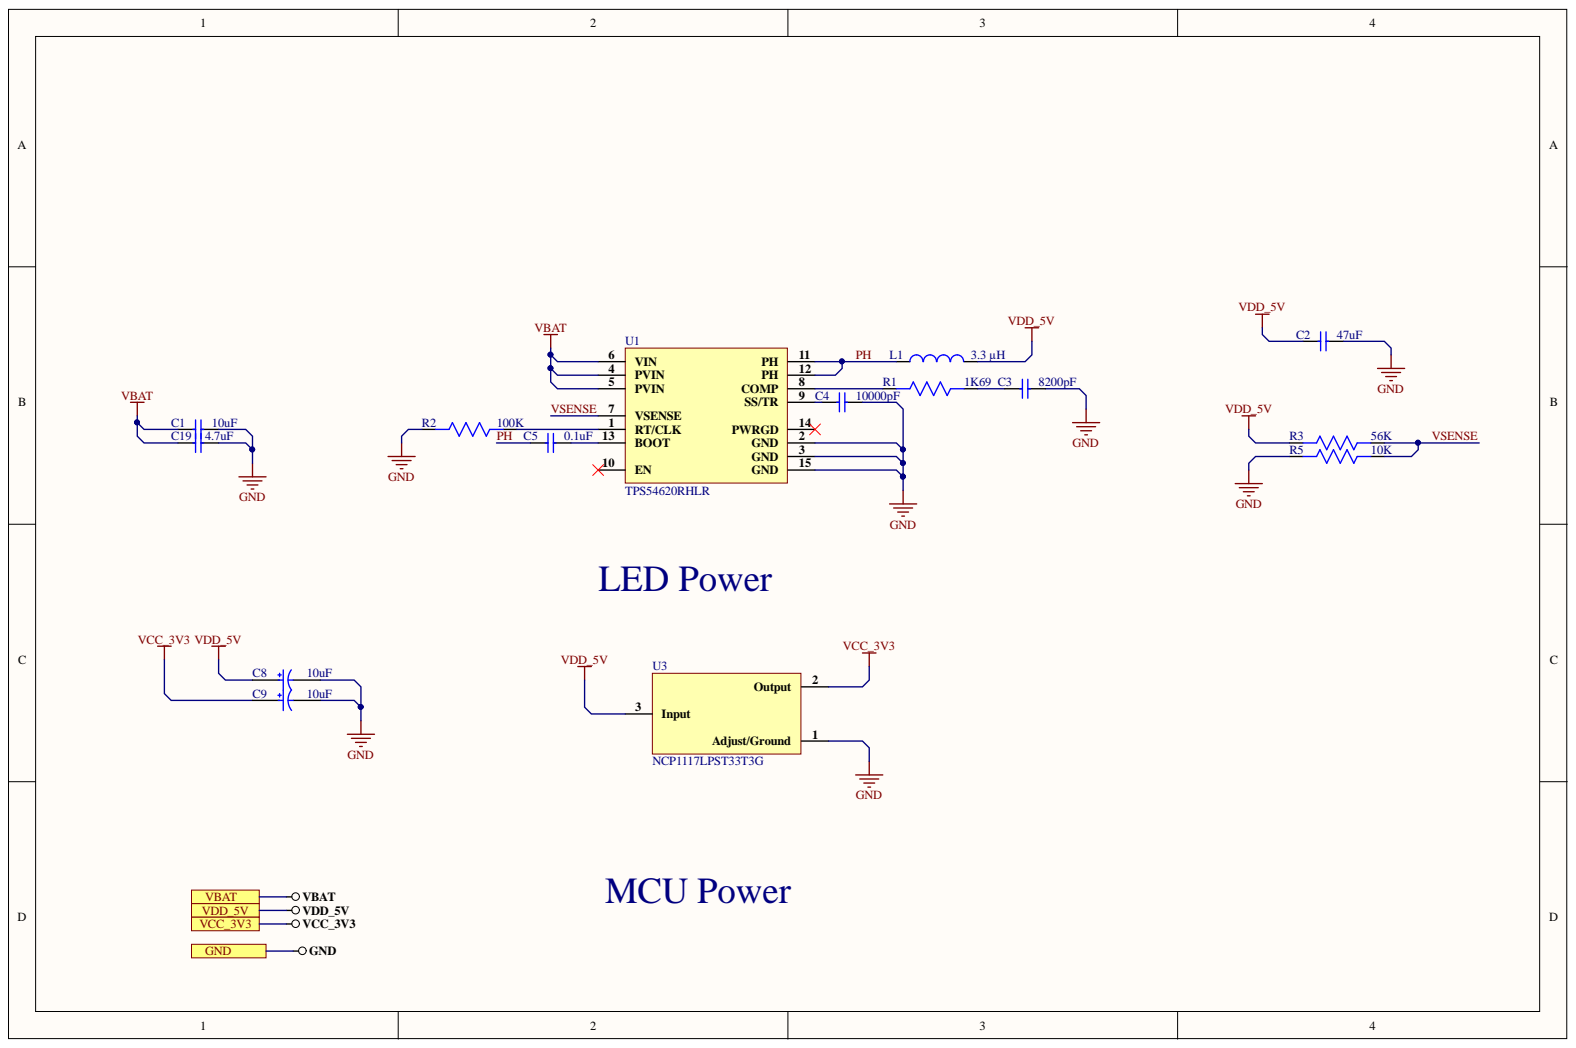
[picture p13: page 2]

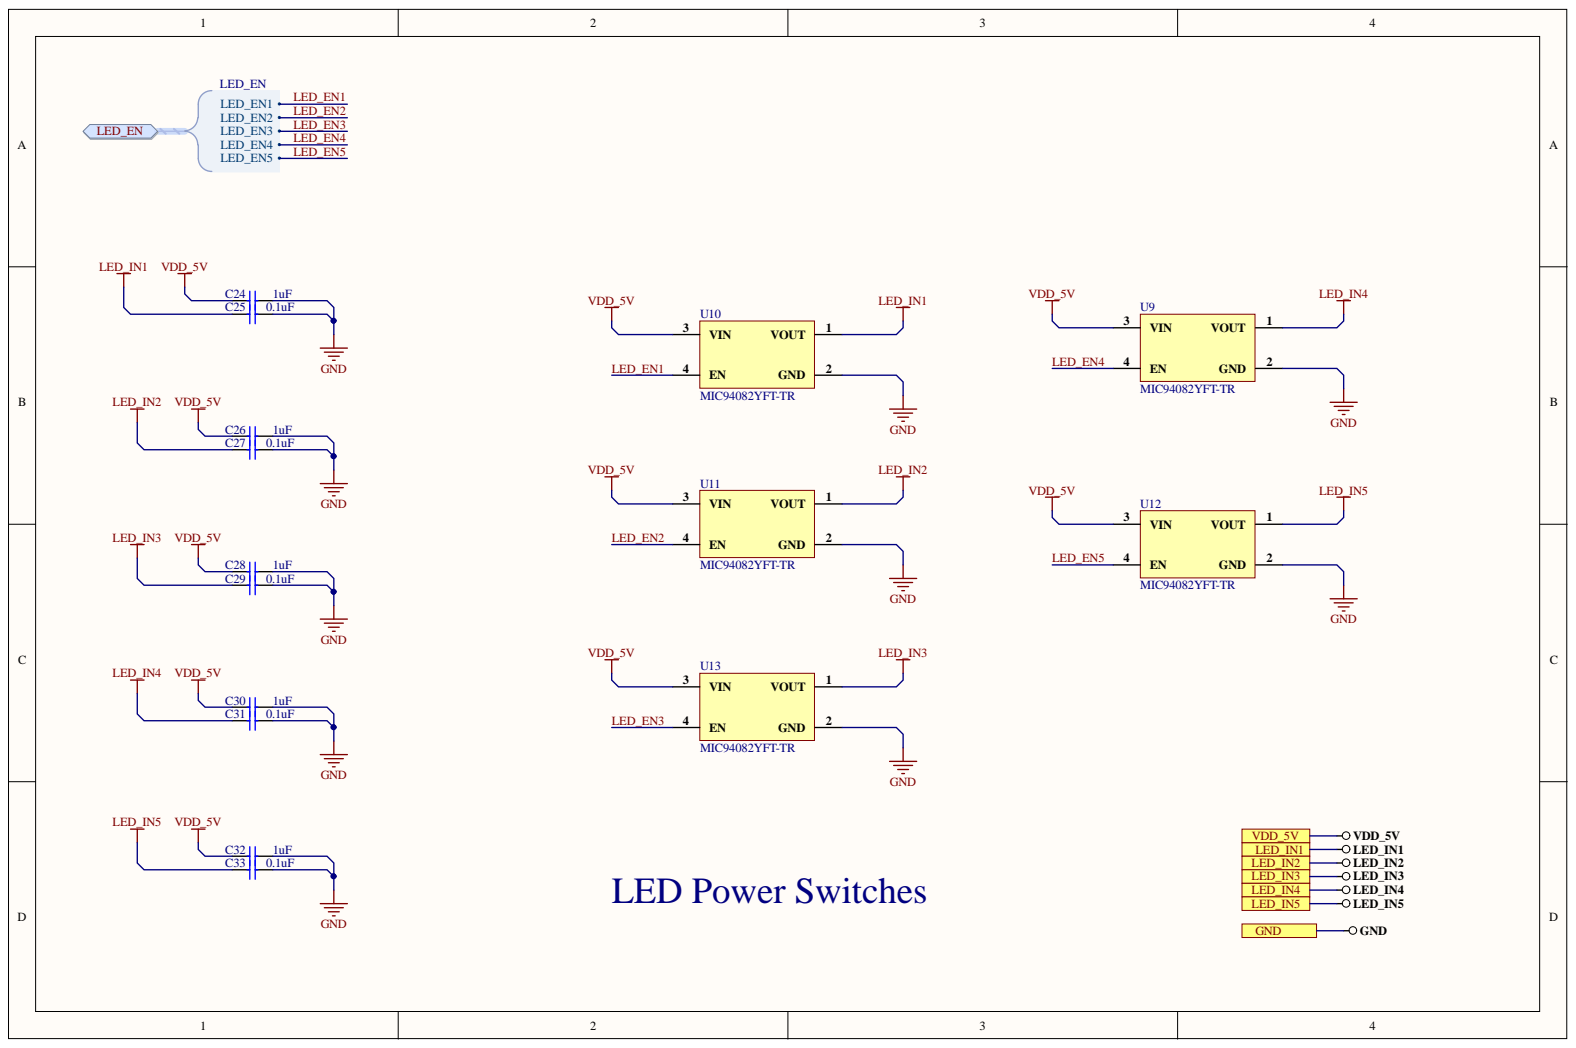
[picture p14: page 3]

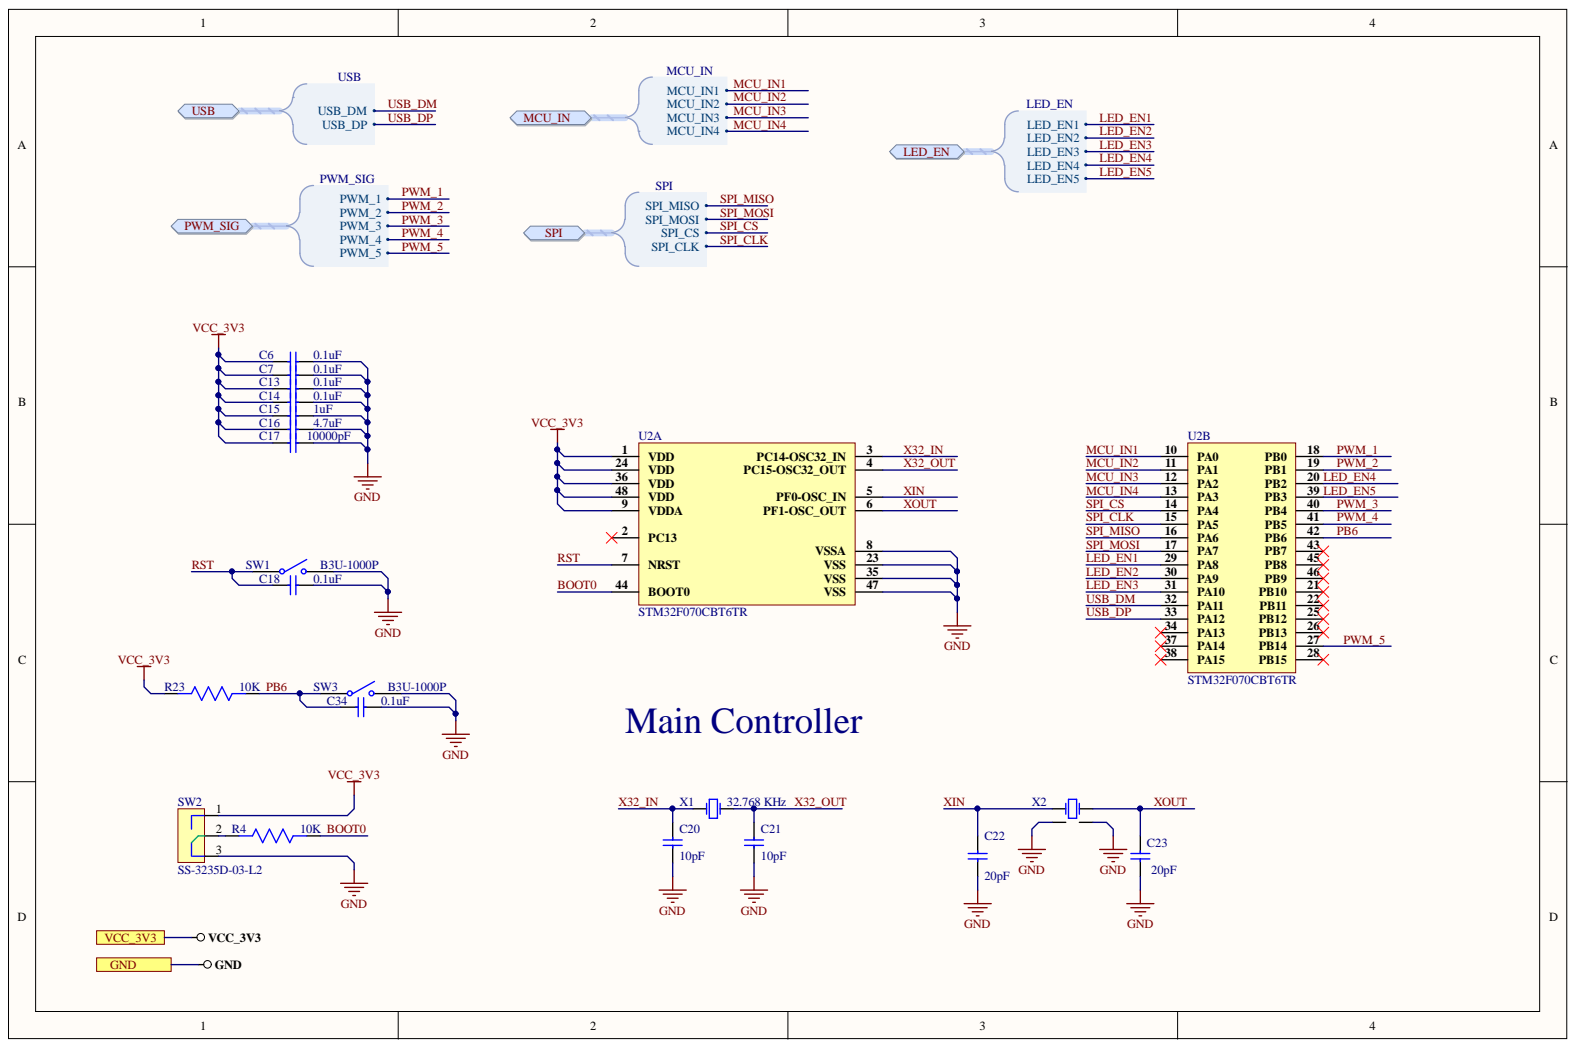
[picture p15: page 4]

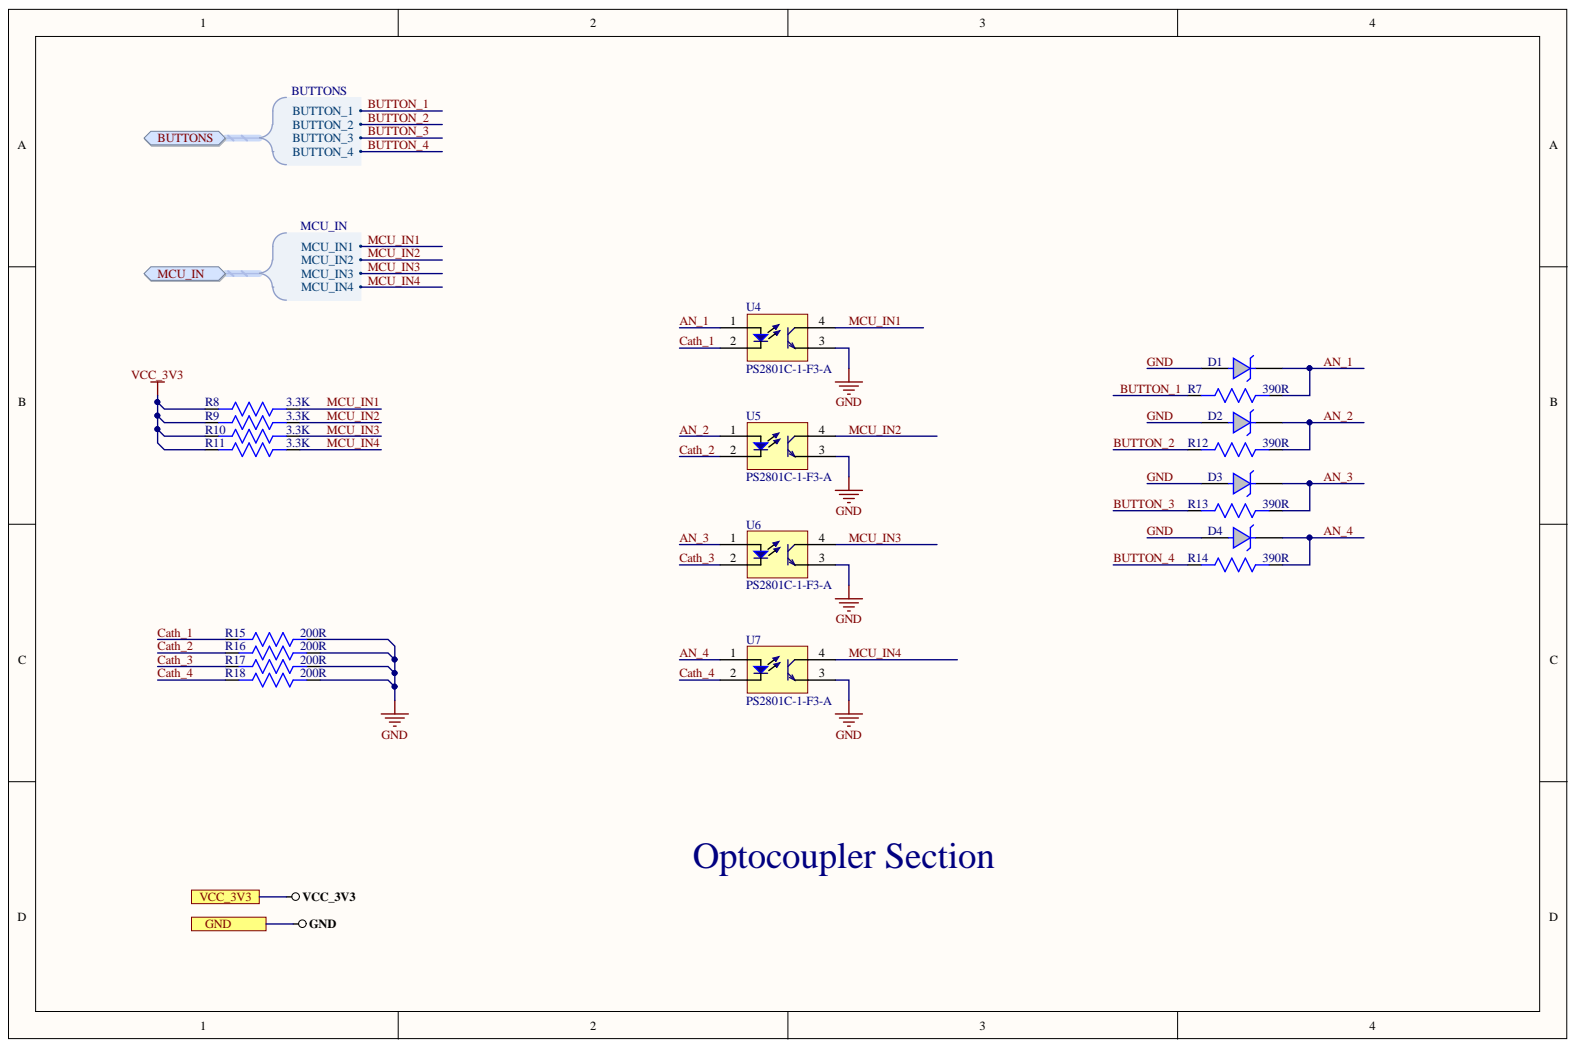
[picture p16: page 5]

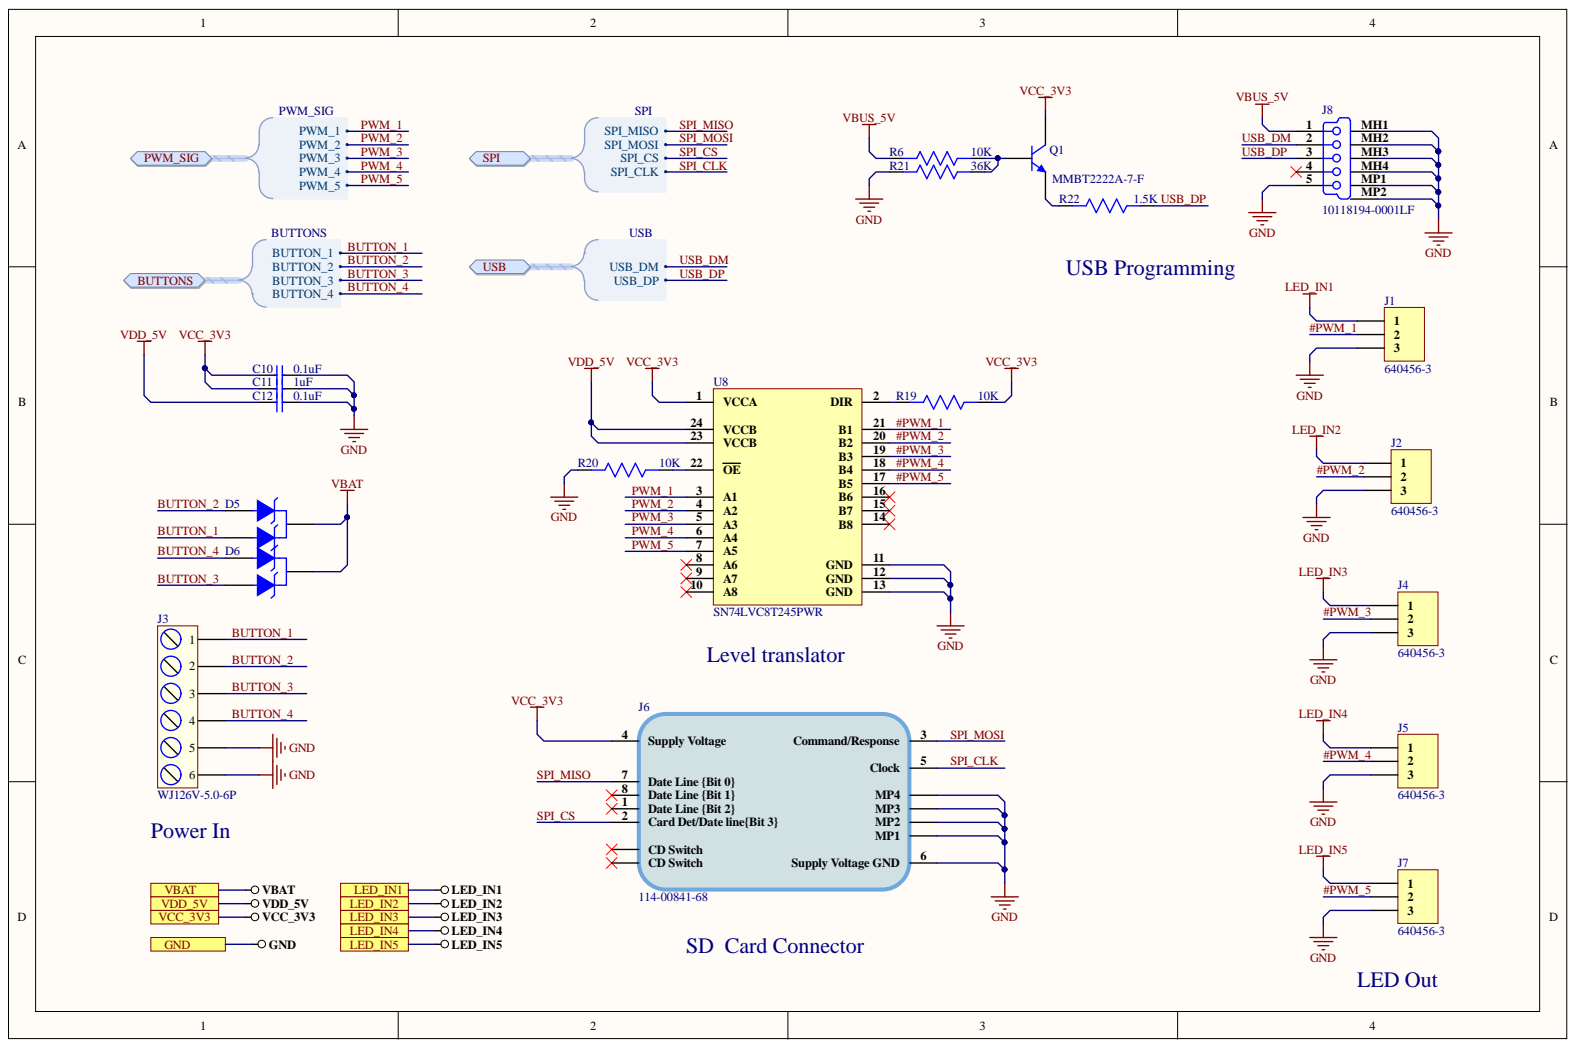
[picture p17: page 6]

Date Line {Bit 0} 7
Date Line {Bit 1} 8
Date Line {Bit 2} 1
Card Det/Date line{Bit 3} 2
