eSpark-Backup/saleemd-customproduct/Hardware-Development/Documents/Client-Files/Saleem D.pdf

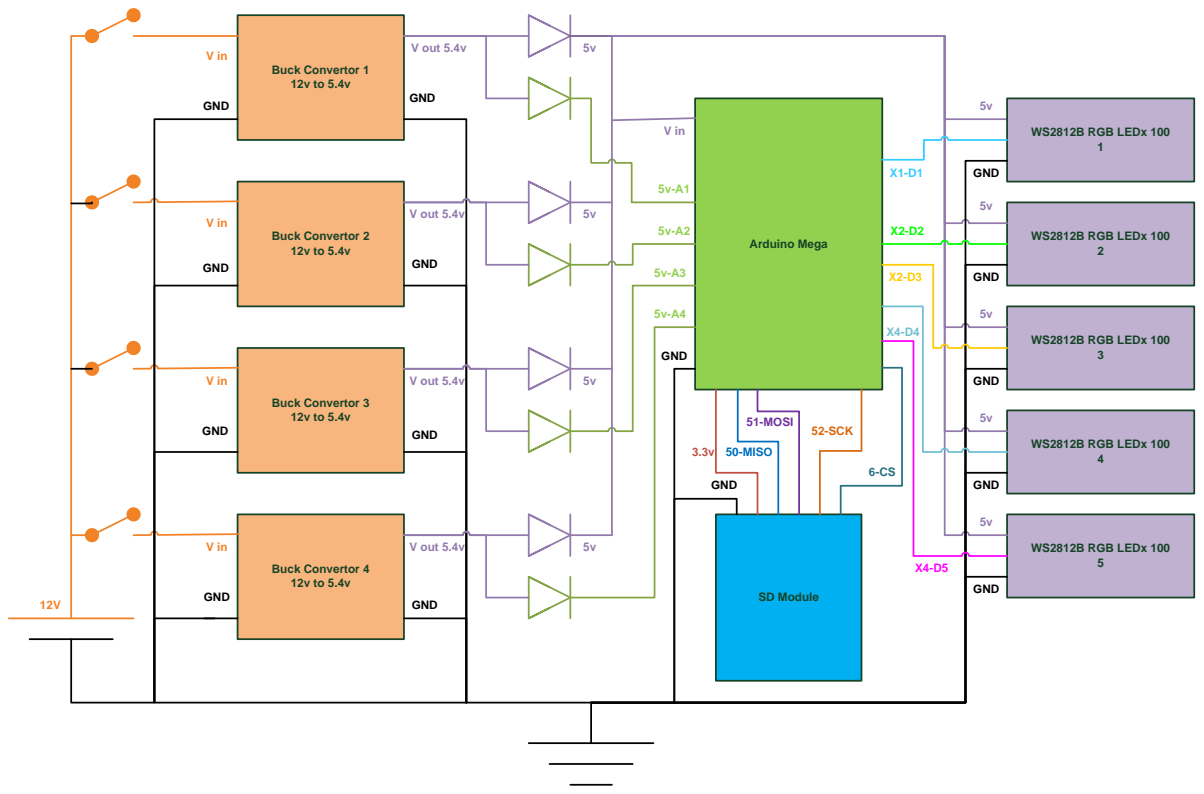
[picture p18: page 1]
