eSpark-Backup/saleemd-customproduct/(list of files, drawings)

Other design files:
Hardware-Development/Design-Files/Connector_Section.SchDoc
Hardware-Development/Design-Files/Controller_Section.SchDoc
Hardware-Development/Design-Files/LED_PWR_CTRL_Section.SchDoc
Hardware-Development/Design-Files/Opto_Section.SchDoc
Hardware-Development/Design-Files/Power_Section.SchDoc
Hardware-Development/Design-Files/Saleem_PCB.PcbDoc
Hardware-Development/Design-Files/SaleemD_Project.PrjPcb
Hardware-Development/Design-Files/Top_Sheet.SchDoc
Hardware-Development/Library-Files/S_D.PcbLib
Hardware-Development/Library-Files/S_D.SchLib
