eSpark-Backup/saleemd-customproduct/(commit log)

2021-09-01 ICs and LED connector suggested in part selection xls.
    [Part Selection.xlsx]
2021-09-03 Updated Part Selection Doc.
    New components added and previous ones have been updated according to the new circuit design guidelines.
    [Part Selection.xlsx]
2021-09-06 Latest Library Files
    [S_D.PcbLib, S_D.SchLib]
2021-09-07 Power section added with 12-5V converter and 3.3V regulator. LED connectors, buffer IC and input terminals also added..
    [Connector_Section.SchDoc, Controller_Section.SchDoc, Power_Section.SchDoc, S_D.PcbLib, S_D.SchLib, SaleemD_Project.PrjPcb, Top_Sheet.SchDoc]
2021-09-08 SD card, opto section, transceiver IC and power IC added to library and design.
    [Connector_Section.SchDoc, Controller_Section.SchDoc, Opto_Section.SchDoc, Power_Section.SchDoc, S_D.PcbLib, S_D.SchLib, SaleemD_Project.PrjPcb, Top_Sheet.SchDoc]
2021-09-09 Updated Library (SN74LVC8T245MPWREP) Ye IC add kr di ha library me (TPS22965-Q1) is IC ka thermal PAD ni tha @Urooj-naveed Wo b sahi kr dia ha or Res 1218 ka footprint b add kr dia ha
    [S_D.PcbLib, S_D.SchLib]
2021-09-09 Top sheet connections and decoupling caps added.
    [Connector_Section.SchDoc, Controller_Section.SchDoc, Power_Section.SchDoc, Top_Sheet.SchDoc]
2021-09-09 EN & PWRGD pin corrected in power section.
    [Connector_Section.SchDoc, Controller_Section.SchDoc, Power_Section.SchDoc, Top_Sheet.SchDoc]
2021-09-09 Updated Library (ATMEGA2560-16AU) , (STM32F070CBT6) , Test point and Solder Bridge add kr diye Library me
    [S_D.PcbLib, S_D.SchLib]
2021-09-10 design errors removed. Oring circuit added.
    [Connector_Section.SchDoc, Power_Section.SchDoc, S_D.PcbLib, S_D.SchLib, SaleemD_Project.PrjPcb]
2021-09-11 Minor Corrections in Connector Section
    [Connector_Section.SchDoc, Controller_Section.SchDoc, Opto_Section.SchDoc, Part Selection.xlsx, Power_Section.SchDoc, SaleemD_Project.PrjPcb, Top_Sheet.SchDoc]
2021-09-13 Controller section and more power switches added. Library updated.
    [Connector_Section.SchDoc, Controller_Section.SchDoc, LED_PWR_CTRL_Section.SchDoc, Power_Section.SchDoc, S_D.PcbLib, S_D.SchLib, SaleemD_Project.PrjPcb, Top_Sheet.SchDoc]
2021-09-14 errors removed. GND issue resolved. 8200pF cap added to lib.
    [Connector_Section.SchDoc, Controller_Section.SchDoc, LED_PWR_CTRL_Section.SchDoc, Opto_Section.SchDoc, Power_Section.SchDoc, S_D.PcbLib, S_D.SchLib, SaleemD_Project.PrjPcb]
2021-09-20 Part no: MIC94082YFT-TR added in library
    [S_D.PcbLib, S_D.SchLib]
2021-09-20 Power switch replaced
    [Connector_Section.SchDoc, LED_PWR_CTRL_Section.SchDoc, Power_Section.SchDoc, S_D.SchLib, Top_Sheet.SchDoc]
2021-09-25 Corrected design issues highlighted in schematic review.
    [Connector_Section.SchDoc, Opto_Section.SchDoc, S_D.SchLib]
2021-09-27 PDF created and Sheets annotated properly.
    [Connector_Section.SchDoc, Controller_Section.SchDoc, LED_PWR_CTRL_Section.SchDoc, Opto_Section.SchDoc, Power_Section.SchDoc, SaleemD_Project.PrjPcb, Top_Sheet.SchDoc]
2021-10-03 PCB Designing.
    [Connector_Section.SchDoc, Controller_Section.SchDoc, LED_PWR_CTRL_Section.SchDoc, Opto_Section.SchDoc, Power_Section.SchDoc, SaleemD_Project.PrjPcb, Saleem_PCB.PcbDoc, Top_Sheet.SchDoc]
2021-10-05 Latest library and Schematic.
    [Connector_Section.SchDoc, Controller_Section.SchDoc, Opto_Section.SchDoc, Power_Section.SchDoc, S_D.PcbLib, S_D.SchLib, Saleem_PCB.PcbDoc]
2021-10-06 button added and pcb updated.
    [Connector_Section.SchDoc, Controller_Section.SchDoc, Opto_Section.SchDoc, Power_Section.SchDoc, S_D.SchLib, SaleemD_Project.PrjPcb, Saleem_PCB.PcbDoc]
2021-10-06 PCB file updated.
    [Saleem_PCB.PcbDoc]
2021-10-06 Latest File Uploaded.
    [Saleem_PCB.PcbDoc]
2021-10-06 Changes in PCB and Routing.
    [Connector_Section.SchDoc, Controller_Section.SchDoc, LED_PWR_CTRL_Section.SchDoc, Opto_Section.SchDoc, Power_Section.SchDoc, SaleemD_Project.PrjPcb, Saleem_PCB.PcbDoc, Top_Sheet.SchDoc]
2021-10-09 PCB Routing.
    [Connector_Section.SchDoc, Controller_Section.SchDoc, LED_PWR_CTRL_Section.SchDoc, Opto_Section.SchDoc, Power_Section.SchDoc, SaleemD_Project.PrjPcb, Saleem_PCB.PcbDoc, Top_Sheet.SchDoc]
2021-10-09 PCB Routing Completed.
    [Connector_Section.SchDoc, Controller_Section.SchDoc, LED_PWR_CTRL_Section.SchDoc, Opto_Section.SchDoc, Power_Section.SchDoc, Saleem_PCB.PcbDoc, Top_Sheet.SchDoc]
2021-10-10 Changes in Routing.
    [Connector_Section.SchDoc, Controller_Section.SchDoc, LED_PWR_CTRL_Section.SchDoc, Opto_Section.SchDoc, Power_Section.SchDoc, Saleem_PCB.PcbDoc, Top_Sheet.SchDoc]
2021-10-11 Latest library (114-00841-68) overlay issue resolve
    [S_D.PcbLib, S_D.SchLib]
2021-10-11 Latest Files
    [Connector_Section.SchDoc, Controller_Section.SchDoc, LED_PWR_CTRL_Section.SchDoc, Opto_Section.SchDoc, Power_Section.SchDoc, S_D.PcbLib, S_D.SchLib, SaleemD_Project.PrjPcb]
2021-10-11 All files replaced with updated files from @mars-virgo.
    Design files and deliverables were updated by @mars-virgo
    [Connector_Section.SchDoc, Controller_Section.SchDoc, LED_PWR_CTRL_Section.SchDoc, Opto_Section.SchDoc, Pick Place for Saleem_PCB.csv, Power_Section.SchDoc, S_D.PcbLib, S_D.SchLib]
2021-10-14 BOM Creation Paused
    [BOM_LCSC.xlsx, Digikey_BOM.xlsx, SaleemD_Project.PrjPcb, SaleemD_Project.xlsx]
2021-10-15 Latest BOM
    [BOM_LCSC.xlsx, Digikey_BOM.xlsx]
2021-10-18 SD card and 3.3uH IND updated in lob, schematic and PCB. BOM also updated.
    [BOM_LCSC.xlsx, Connector_Section.SchDoc, LED_PWR_CTRL_Section.SchDoc, Power_Section.SchDoc, S_D.PcbLib, S_D.SchLib, Saleem_PCB.PcbDoc]
2021-10-18 Deleted old Gerber and NC Drill Files.
    [Connector_Section.SchDoc, Controller_Section.SchDoc, LED_PWR_CTRL_Section.SchDoc, Opto_Section.SchDoc, Power_Section.SchDoc, SaleemD_Project.PrjPcb, Saleem_PCB.PcbDoc, Top_Sheet.SchDoc]
2021-10-18 Latest Library SD Card Overlay issue resolve
    [S_D.PcbLib, S_D.SchLib]
2021-10-19 Changes in PCB Design.
    [Connector_Section.SchDoc, Controller_Section.SchDoc, LED_PWR_CTRL_Section.SchDoc, Opto_Section.SchDoc, Pick Place for Saleem_PCB.csv, Power_Section.SchDoc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]
2021-10-19 Both parts are updated in Schematic and in PCB. Fresh Deliverables created.
    [Connector_Section.SchDoc, Controller_Section.SchDoc, LED_PWR_CTRL_Section.SchDoc, Opto_Section.SchDoc, Pick Place for Saleem_PCB.csv, Power_Section.SchDoc, S_D.PcbLib, S_D.SchLib]
2021-10-21 SD card connector 3D body added. part updated in lib, schematic and PCB.
    [Connector_Section.SchDoc, S_D.PcbLib, SaleemD_Project.PrjPcb, Saleem_PCB.PcbDoc]
2021-10-22 Latest library files Missing parts issue Resolve
    [S_D.PcbLib, S_D.SchLib]
2021-10-22 Changes in PCB done. Fresh Deliverables created.
    [Connector_Section.SchDoc, Controller_Section.SchDoc, LED_PWR_CTRL_Section.SchDoc, Opto_Section.SchDoc, Pick Place for Saleem_PCB.csv, Power_Section.SchDoc, SaleemD_Project.PrjPcb, SaleemD_Project.xlsx]
2021-10-23 power switch link and price added to LCSC BOM
    [BOM_LCSC.xlsx]
2021-11-03 Fabrication BOM Add kia ha LCSC BOM ki price Change hui ha Digikey BOM me alternate part add howe han
    [BOM_LCSC.xlsx, Digikey_BOM.xlsx, Fabrication BOM .xlsx]
2021-11-03 LCSC Links ko Custom Supplier kr dia ha or price bardha di ha
    [Digikey_BOM.xlsx]
2021-12-10 LCSC and fabrication BOM reviewed.
    [BOM_LCSC.xlsx, Fabrication BOM .xlsx, SaleemD_Project_Altium.xlsx]
2021-12-13 Extra rows removed from Fabrication BOM
    [Fabrication BOM .xlsx]
2021-12-13 quote from Karen has been added to LCSC BOM
    [BOM_LCSC.xlsx]
2022-01-29 Created Folder Structure to distinguish Firmware files
    [BOM_LCSC.xlsx, Connector_Section.SchDoc, Controller_Section.SchDoc, Digikey_BOM.xlsx, Fabrication BOM .xlsx, LED_PWR_CTRL_Section.SchDoc, Opto_Section.SchDoc, Part Selection.xlsx]
2022-02-14 tested turning on and off of 241 RGB LEDs successfully
2022-02-14 updated test code - turning on white 100 LEDs per mosfet each time
2022-02-15 tested 50 x 4 white LEDs turning on and off simultaneously
2022-02-22 completed test code for detecting button clicks - remaining testing
2022-02-25 combined code of printing button states and led switching
2022-02-28 resolved issue with PWM1 of not able to turn on enough leds
    [HelloWorld_50x4whireLEDS_constant.ino]
